iic-jku/SKY130_PLL1/buffer.JPG

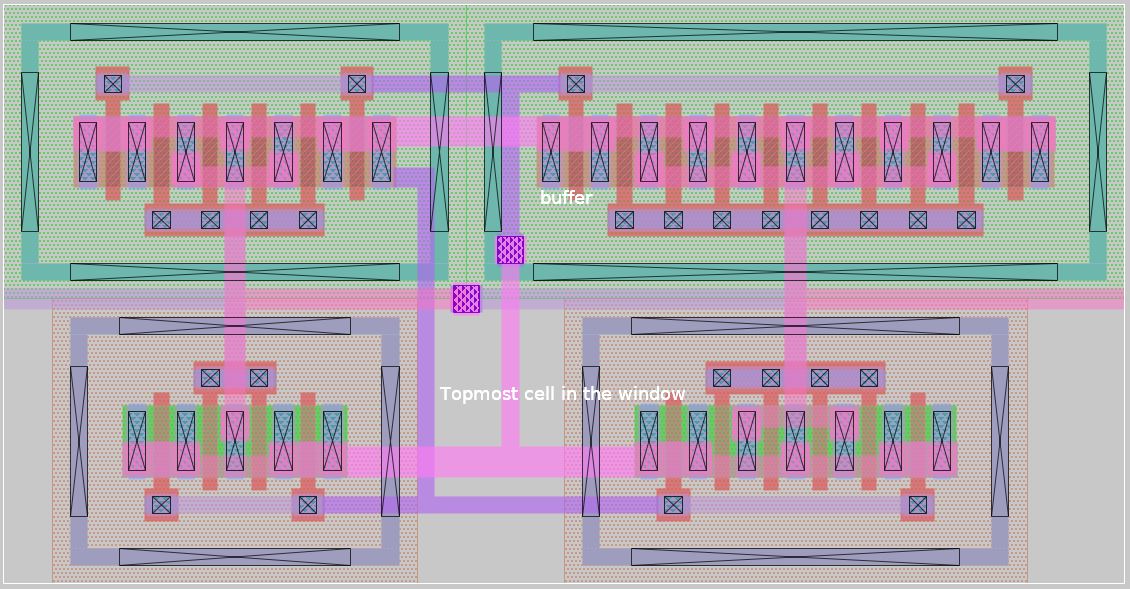
buffer.JPG
