iic-jku/SKY130_PLL1/core_final.JPG

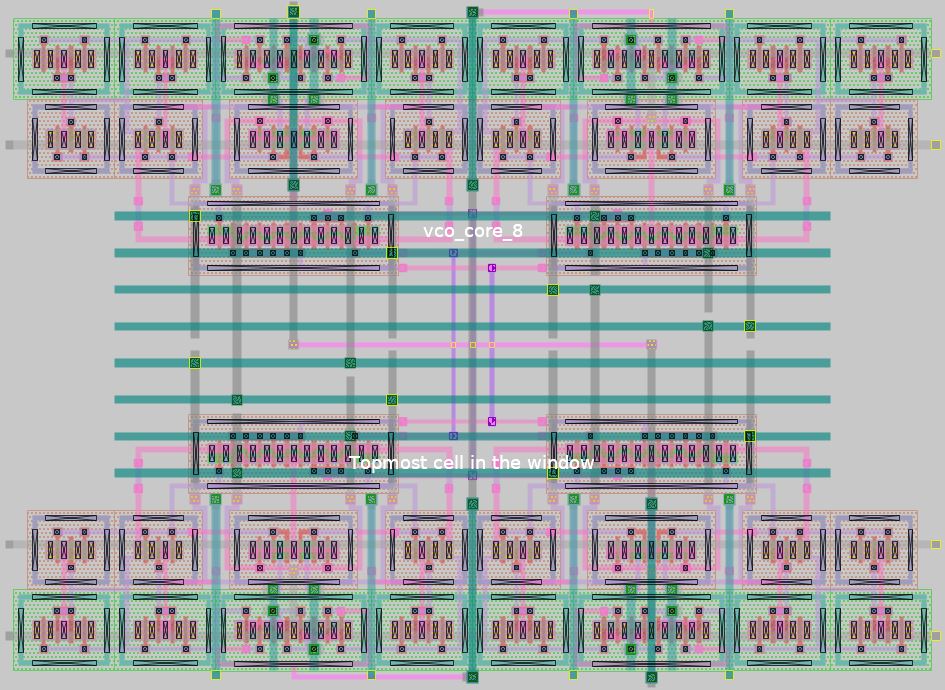
core_final.JPG
