iic-jku/SKY130_PLL1/README.md

# pll2022
Implementation of a Sub-Sampling PLL targeting SerDes Applications
__________________________________________________________________

Submission(s) for precheck - 31.08.2022:
> folder "PICO Contest"
> includes Pin List as well as "pin dummy"(dummy project but with all the correct pins)
