iic-jku/SKY130_PLL1/eval/digital_configuration/sky130_pll_controller/s1_SPI_Master.runs/impl_1/.init_design.begin.rst

<?xml version="1.0"?>
<ProcessHandle Version="1" Minor="0">
    <Process Command=".planAhead." Owner="fath_local" Host="PABLO" Pid="19500">
    </Process>
</ProcessHandle>
