iic-jku/SKY130_PLL1/eval/digital_configuration/sky130_pll_peripheral/sky130_pll_peripheral.runs/synth_1/.vivado.begin.rst

<?xml version="1.0"?>
<ProcessHandle Version="1" Minor="0">
    <Process Command="vivado.bat" Owner="fath_local" Host="PABLO" Pid="7096" HostCore="8" HostMemory="034122080256">
    </Process>
</ProcessHandle>
