iic-jku/SKY130_PLL1/PICO Contest/presentation.pptx

## Implementation of a Sub-Sampling PLL targeting SerDes Applications

Christof Gindu, BSc
Rohish Kumar Reddy Mitta, MSc
Univ.-Prof. Dr. Harald Pretl

## Team

- Christof Gindu, BSc Student
- Rohish Kumar Reddy Mitta, MSc PhD candidate, supervisor
- Univ.-Prof. Dr. Harald Pretl head of institute, supervisor

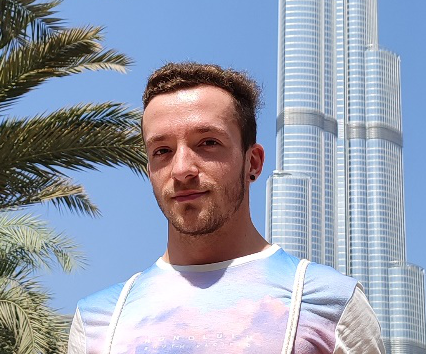
[picture p14: figure]
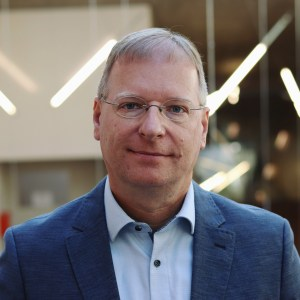
[picture p15: figure]

## Block schematic

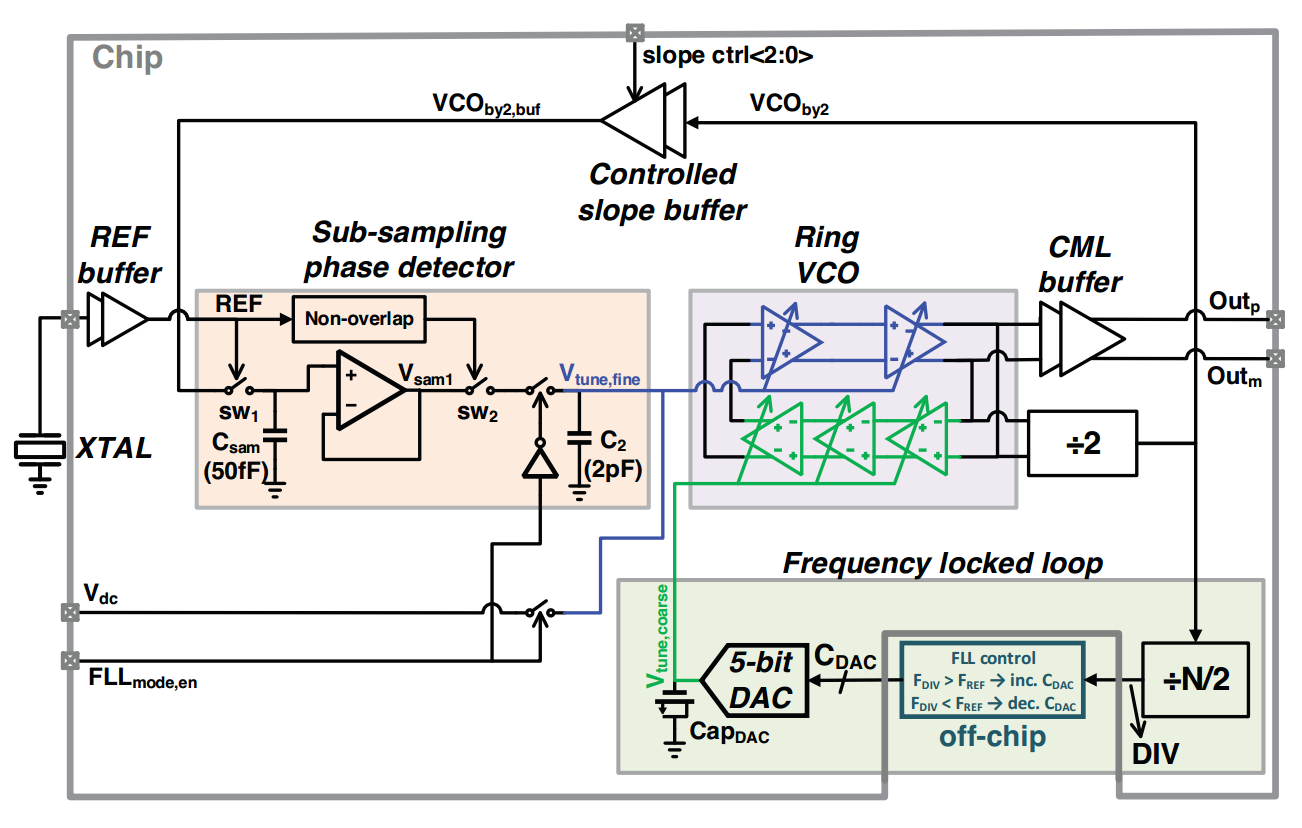
[picture p16: figure]

- S. S. Nagam and P. R. Kinget, "A 0.008mm2 2.4GHz type-I sub-sampling ring-oscillator-based phase-locked loop with a −239.7dB FoM and −64dBc reference spurs," 2018 IEEE Custom Integrated Circuits Conference (CICC), 2018, pp. 1-4, doi: 10.1109/CICC.2018.8357091.

## Proposed block schematic


## Specifications

- Center frequency = 1.25 GHz -> SerDes Applications
- Input frequency = 10-100 MHz (26 MHz) (mobile Applications)
- Power supply = 1.80V
- Power budget = 5 mW maximum
- Design focus on low power consumption (switching off circuit components)
- Design focus on PVT corners

## Ring VCO simulation

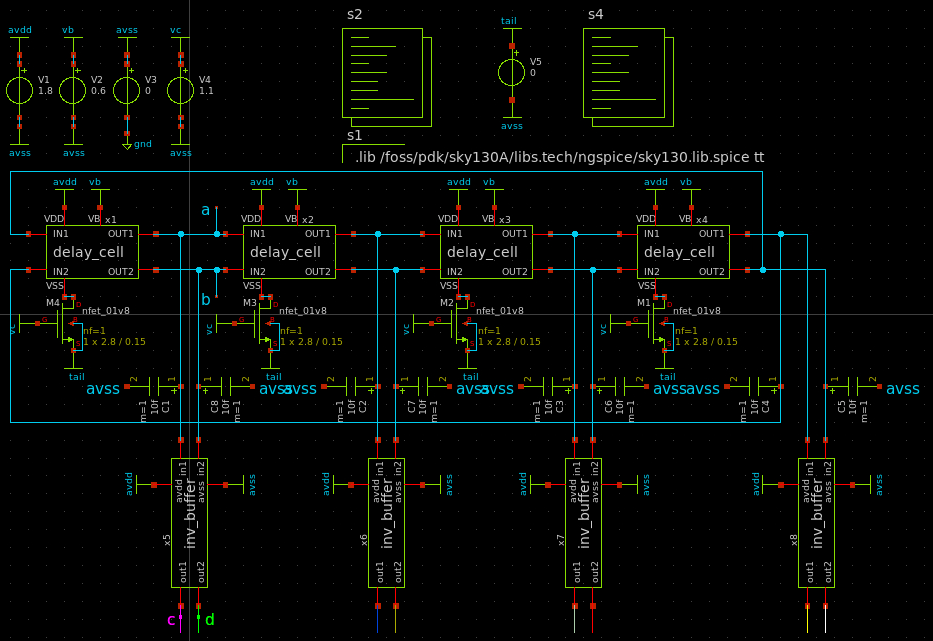
[picture p17: figure]

## Simulation results

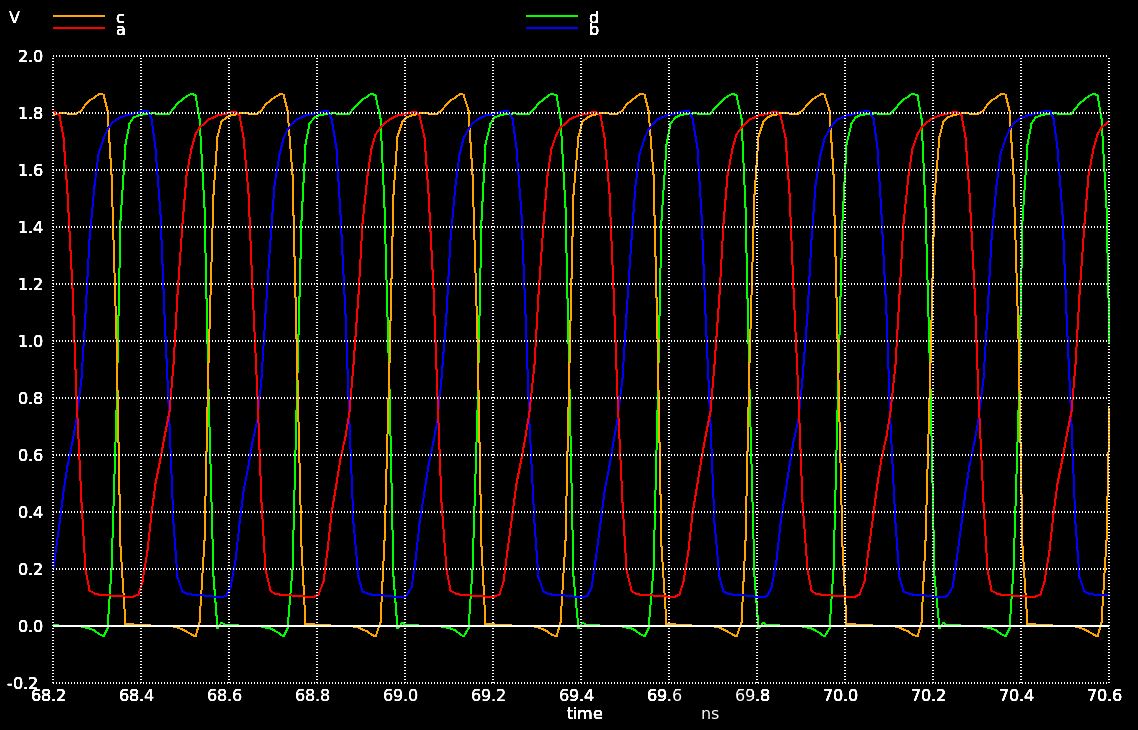
[picture p18: figure]

## Simulation results

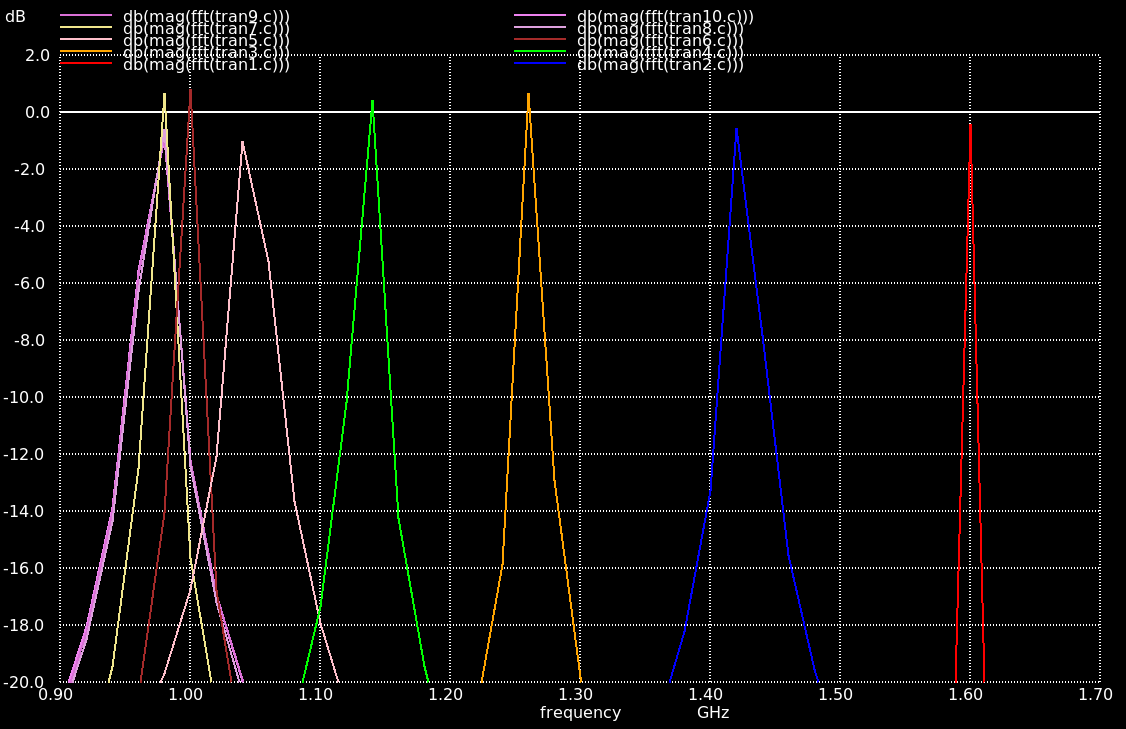
[picture p19: figure]

## VCO behavior

## Layout of the delay cell

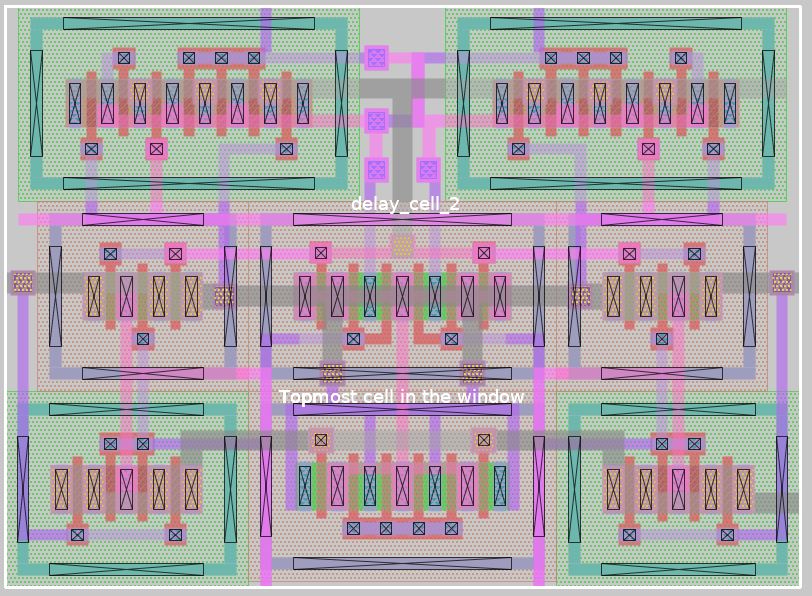
[picture p20: figure]

## Layout of the complete ring VCO

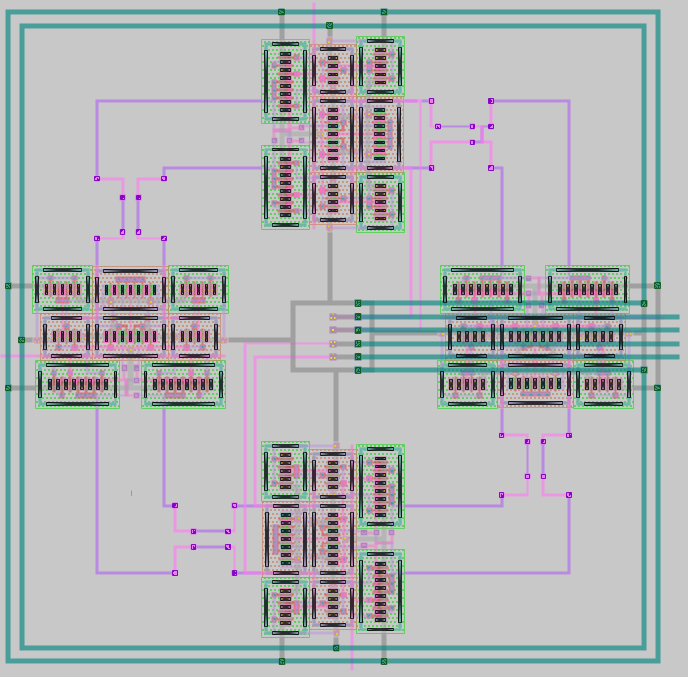
[picture p21: figure]

## Next steps

- Improve top speed of ring VCO
- Improve tuning range of ring VCO
- Start with extractions
- Continue with next circuit components

## Design challenges

- Extractions for LVS
- Parasitic extraction
- Incorporating all PVT corners

## Thank you!

Any questions / recommendations / feedback?
