iic-jku/SKY130_PLL1/PICO Contest/caravel_user_project_analog/README.md

# Caravel Analog User

  

---

| :exclamation: Important Note            |
|-----------------------------------------|

## Please fill in your project documentation in this README.md file
sub-sampling PLL targeting SerDes Applications
**********************************************
13 Pins in total
3x supply (vdd/vss)
1x REF in
1x s_in
1x read
1x load
1x clk
1x s_out
1x OUT

:warning: | Use this sample project for analog user projects. 
:---: | :---

---

Refer to [README](docs/source/index.rst) for this sample project documentation.
