iic-jku/SKY130_PLL1/Verilog/wrapper/runs/RUN_2023.03.12_07.43.52/reports/routing/18-wire_lengths.csv

net | length_um
clknet_0_clk_in | 398.89
_0478_ | 345.38
_0750_ | 331.885
_0757_ | 318.275
_0911_ | 293.235
net2 | 286.015
_0773_ | 186.75
_0771_ | 178.395
d5.fll_core.strobe | 175.14
clknet_4_2_0_clk_in | 174.155
_0923_ | 172.43
_0777_ | 169.995
_0769_ | 169.785
_0912_ | 162.215
_0508_ | 160.755
_0761_ | 159.125
_0979_ | 153.11
_0775_ | 147.905
_0776_ | 146.74
_0751_ | 144.09
_0758_ | 142.845
clknet_4_8_0_clk_in | 142.38
net28 | 141.975
_0756_ | 139.835
clknet_4_11_0_clk_in | 138.785
d2.t_load\[33\] | 138.62
net19 | 138.09
_0760_ | 136.29
clk_in | 134.655
_0574_ | 134.585
_0755_ | 134.015
_0968_ | 133.905
clknet_4_13_0_clk_in | 132.52
_0754_ | 132.03
clknet_4_10_0_clk_in | 131.93
net36 | 131.175
_0498_ | 130.285
clknet_1_0__leaf_ref_in | 130.03
_0542_ | 129.875
net27 | 129.23
_0770_ | 128.33
_0530_ | 127.66
_0772_ | 127.545
_0774_ | 126.88
clknet_4_5_0_clk_in | 126.35
d2.t_load\[59\] | 125.965
_0552_ | 123.975
d2.t_load\[58\] | 122.455
_0945_ | 120.85
d5.fll_core.tmp\[9\] | 120.61
net44 | 120.385
_0497_ | 119.95
_0934_ | 119.195
_0618_ | 118.48
clknet_4_14_0_clk_in | 117.87
_0520_ | 117.85
_0640_ | 116.67
net43 | 115.195
_0596_ | 114.685
_0630_ | 114.61
clknet_4_4_0_clk_in | 112.61
d2.t_load\[60\] | 111.995
d5.fll_core.tmp\[7\] | 111.77
net20 | 111.315
clknet_1_1__leaf_ref_in | 110.855
d5.fll_core.tmp\[2\] | 110.415
net18 | 110.17
net42 | 109.94
d5.fll_core.tmp\[8\] | 109.905
_0954_ | 109.73
clknet_4_0_0_clk_in | 109.615
d2.t_load\[31\] | 108.895
d2.t_load\[65\] | 108.82
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
_0527_ | 1.695
_0604_ | 1.695
_0027_ | 1.575
_0049_ | 1.575
_0057_ | 1.575
_0060_ | 1.575
_0071_ | 1.575
_0079_ | 1.575
_0107_ | 1.575
_0110_ | 1.575
_0121_ | 1.575
_0127_ | 1.575
_0177_ | 1.575
_0198_ | 1.575
_0205_ | 1.575
_0241_ | 1.575
_0407_ | 1.545
_0628_ | 1.45
_0706_ | 1.45
