iic-jku/SKY130_PLL1/Verilog/wrapper/runs/RUN_2022.11.11_11.09.27/reports/routing/18-wire_lengths.csv

net | length_um
clknet_0_clk_in | 392.18
_0802_ | 345.365
_0772_ | 327.065
net2 | 316.435
_0780_ | 305.995
_0892_ | 265.6
_0784_ | 221.5
_0795_ | 219.115
_0530_ | 197.77
_0783_ | 189.93
_0574_ | 184.62
_0794_ | 181.915
_0814_ | 172.805
_0790_ | 166.215
d5.fll_core.strobe | 165.015
clknet_4_10_0_clk_in | 159.14
_0791_ | 158.77
net27 | 157.075
_0542_ | 151.49
_0792_ | 150.205
clknet_4_15_0_clk_in | 149.045
_0608_ | 148.92
net18 | 143.77
_0618_ | 143.61
_0836_ | 142.74
_0789_ | 141.975
_0788_ | 141.625
_0848_ | 141.55
_0803_ | 141.115
_0870_ | 140.865
net17 | 140.72
clknet_4_5_0_clk_in | 140.565
_0793_ | 140.09
_0777_ | 138.36
_0859_ | 138.18
clknet_4_3_0_clk_in | 135.29
_0652_ | 134.57
_0847_ | 131.315
d2.t_load\[44\] | 131.215
d5.fll_core.tmp\[0\] | 130.6
_0519_ | 128.265
d5.fll_core.tmp\[2\] | 128.09
_0520_ | 127.9
_0785_ | 127.655
_0781_ | 126.915
net26 | 126.63
_0778_ | 126.065
clk_in | 124.995
clknet_4_13_0_clk_in | 123.29
clknet_4_8_0_clk_in | 122.3
_0596_ | 121.83
d2.t_load\[58\] | 121.295
clknet_1_1__leaf_ref_in | 120.695
_0773_ | 120.595
_0564_ | 120.385
_0779_ | 120.305
net19 | 120.225
d2.t_load\[33\] | 119.895
net43 | 119.86
clknet_4_9_0_clk_in | 116.865
_0825_ | 115.94
clknet_1_0__leaf_ref_in | 115.52
_0491_ | 115.35
_0776_ | 115.09
net35 | 114.605
clknet_4_11_0_clk_in | 114.455
d2.t_load\[56\] | 113.65
d2.t_load\[57\] | 113.625
_0782_ | 112.88
d5.fll_core.tmp\[9\] | 112.34
d2.t_load\[62\] | 112.255
clknet_4_2_0_clk_in | 111.71
clknet_4_14_0_clk_in | 110.415
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
_0307_ | 1.79
_0309_ | 1.79
_0328_ | 1.79
_0341_ | 1.79
_0422_ | 1.79
_0334_ | 1.76
_0507_ | 1.695
_0675_ | 1.695
_0027_ | 1.575
_0029_ | 1.575
_0055_ | 1.575
_0067_ | 1.575
_0099_ | 1.575
_0126_ | 1.575
_0157_ | 1.575
_0199_ | 1.575
_0232_ | 1.575
_0251_ | 1.575
_0517_ | 1.45
_0613_ | 1.45
