iic-jku/SKY130_PLL1/delay_cell.JPG

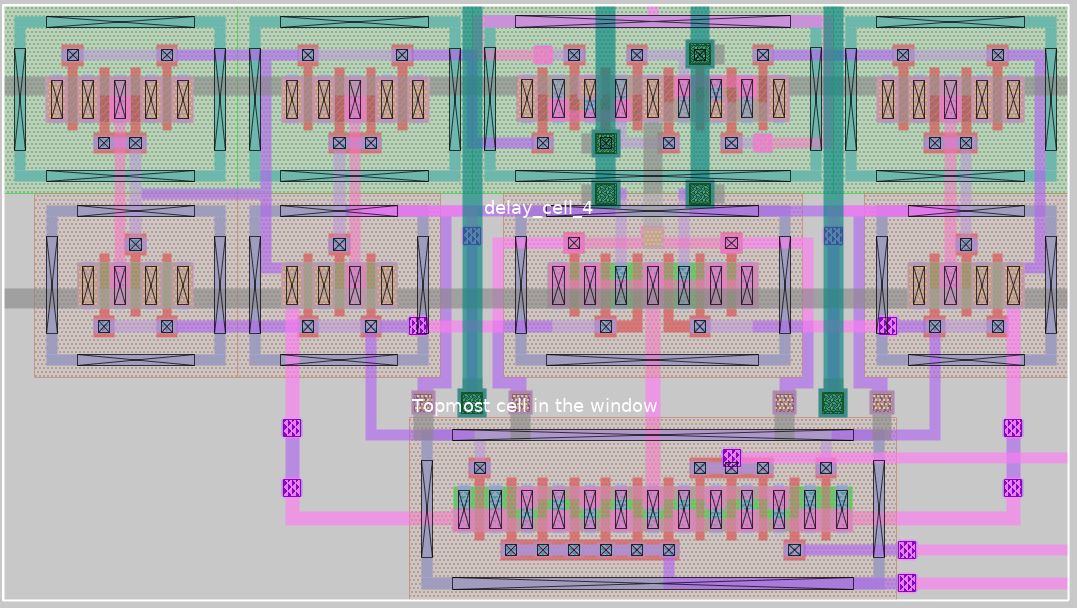
delay_cell.JPG
