iic-jku/SKY130_PLL1/eval/caravan_pad.png

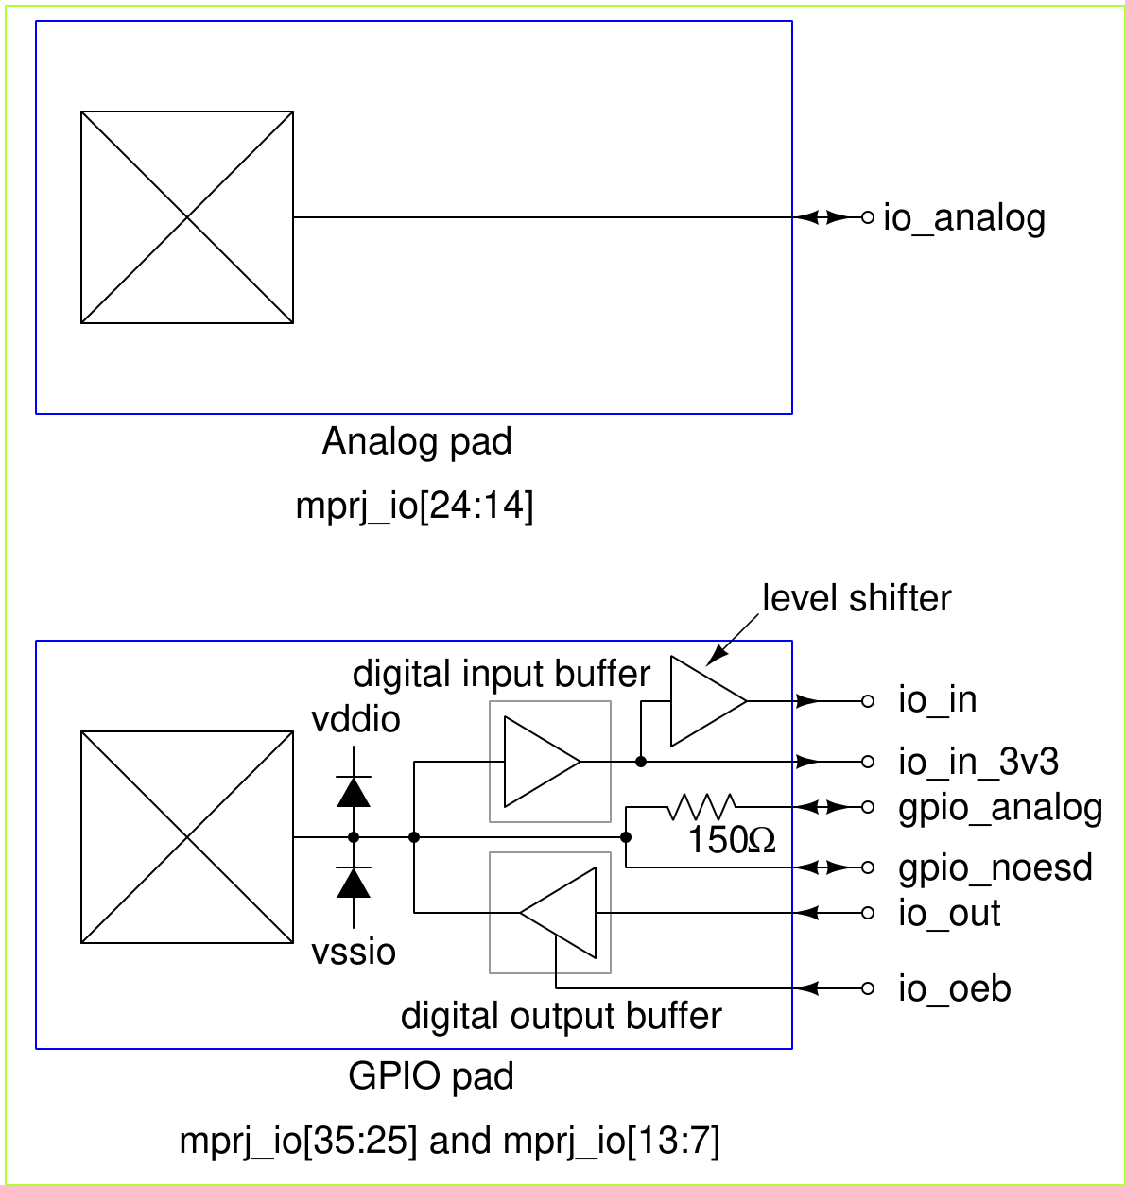
eval/caravan_pad.png
