iic-jku/SKY130_PLL1/eval/SKY130_PLL_eval_PCB/aisler_pcb_stackup.jpeg

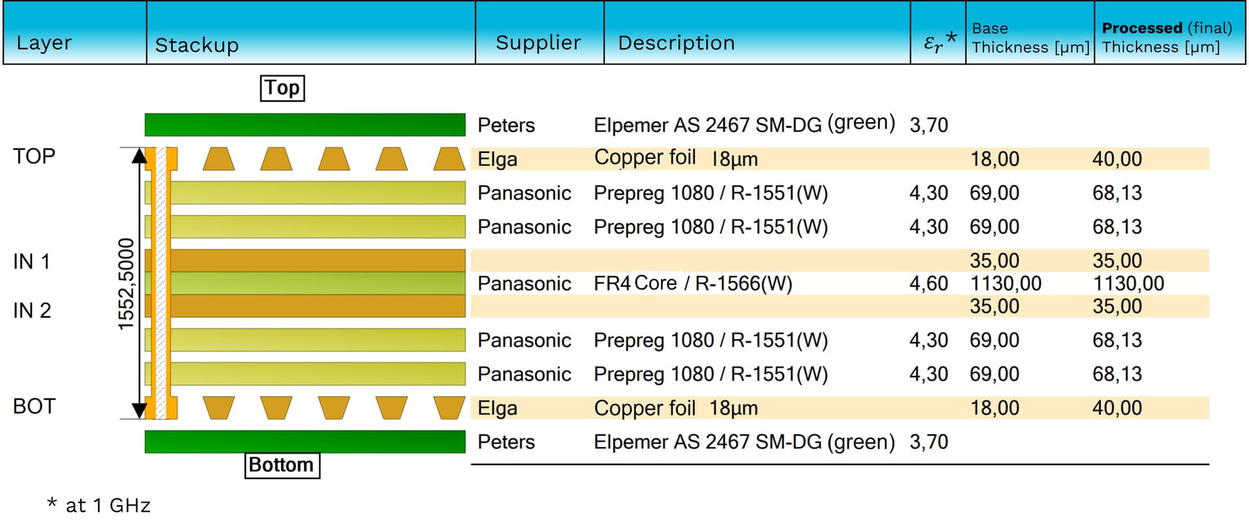
eval/SKY130_PLL_eval_PCB/aisler_pcb_stackup.jpeg
