iic-jku/SKY130_PLL1/eval/SKY130_PLL_eval_PCB/Orderlist.txt

2x ADM7154ARDZ-1.8-R7 7€ https://www.digikey.at/en/products/detail/analog-devices-inc/ADM7154ARDZ-1-8-R7/5055886
