iic-jku/SKY130_PLL1/Verilog/fll_2/runs/RUN_2022.10.07_08.59.13/reports/final_summary_report.csv

 | design | design_name | config | flow_status | total_runtime | routed_runtime | (Cell/mm^2)/Core_Util | DIEAREA_mm^2 | CellPer_mm^2 | OpenDP_Util | Peak_Memory_Usage_MB | cell_count | tritonRoute_violations | Short_violations | MetSpc_violations | OffGrid_violations | MinHole_violations | Other_violations | Magic_violations | antenna_violations | lvs_total_errors | cvc_total_errors | klayout_violations | wire_length | vias | wns | pl_wns | optimized_wns | fastroute_wns | spef_wns | tns | pl_tns | optimized_tns | fastroute_tns | spef_tns | HPWL | routing_layer1_pct | routing_layer2_pct | routing_layer3_pct | routing_layer4_pct | routing_layer5_pct | routing_layer6_pct | wires_count | wire_bits | public_wires_count | public_wire_bits | memories_count | memory_bits | processes_count | cells_pre_abc | AND | DFF | NAND | NOR | OR | XOR | XNOR | MUX | inputs
0 | /foss/designs/ma2022/fll_2 | fll_wrapper_2 | RUN_2022.10.07_08.59.13 | flow completed | 0h3m17s0ms | 0h2m43s0ms | -2.0 | 0.010372210625 | -1 | 53.4 | 475.58 | -1 | 0 | 0 | 0 | 0 | 0 | 0 | 0 | 0 | 0 | 0 | -1 | 9878 | 2527 | 0.0 | 0.0 | -1 | 0.0 | 0.0 | 0.0 | 0.0 | -1 | 0.0 | 0.0 | 5502447.0 | 0.0 | 31.5 | 30.67 | 3.16 | 1.16 | 0.0 | 384 | 691 | 45 | 240 | 0 | 0 | 0 | 428 | 20 | 41 | 22 | 17 | 40 | 81 | 19 | 1 | 86
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
