iic-jku/SKY130_PLL1/Verilog/fll_2/runs/RUN_2022.11.02_10.21.17/reports/final_summary_report.csv

 | design | design_name | config | flow_status | total_runtime | routed_runtime | (Cell/mm^2)/Core_Util | DIEAREA_mm^2 | CellPer_mm^2 | OpenDP_Util | Peak_Memory_Usage_MB | cell_count | tritonRoute_violations | Short_violations | MetSpc_violations | OffGrid_violations | MinHole_violations | Other_violations | Magic_violations | antenna_violations | lvs_total_errors | cvc_total_errors | klayout_violations | wire_length | vias | wns | pl_wns | optimized_wns | fastroute_wns | spef_wns | tns | pl_tns | optimized_tns | fastroute_tns | spef_tns | HPWL | routing_layer1_pct | routing_layer2_pct | routing_layer3_pct | routing_layer4_pct | routing_layer5_pct | routing_layer6_pct | wires_count | wire_bits | public_wires_count | public_wire_bits | memories_count | memory_bits | processes_count | cells_pre_abc | AND | DFF | NAND | NOR | OR | XOR | XNOR | MUX | inputs
0 | /foss/designs/ma2022/fll_2 | fll_wrapper_2 | RUN_2022.11.02_10.21.17 | flow failed | 0h0m26s0ms | -1 | -2.0 | 0.0095067929 | -1 | 54.54 | -1 | -1 | -1 | -1 | -1 | -1 | -1 | -1 | -1 | -1 | -1 | -1 | -1 | -1 | -1 | 0.0 | 0.0 | -1 | -1 | -1 | 0.0 | 0.0 | -1 | -1 | -1 | 6793029.0 | -1 | -1 | -1 | -1 | -1 | -1 | 334 | 668 | 48 | 288 | 0 | 0 | 0 | 366 | 14 | 31 | 15 | 17 | 46 | 70 | 12 | 11 | 77
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
