iic-jku/SKY130_PLL1/Verilog/freqdiv/runs/RUN_2022.10.19_14.29.10/reports/final_summary_report.csv

 | design | design_name | config | flow_status | total_runtime | routed_runtime | (Cell/mm^2)/Core_Util | DIEAREA_mm^2 | CellPer_mm^2 | OpenDP_Util | Peak_Memory_Usage_MB | cell_count | tritonRoute_violations | Short_violations | MetSpc_violations | OffGrid_violations | MinHole_violations | Other_violations | Magic_violations | antenna_violations | lvs_total_errors | cvc_total_errors | klayout_violations | wire_length | vias | wns | pl_wns | optimized_wns | fastroute_wns | spef_wns | tns | pl_tns | optimized_tns | fastroute_tns | spef_tns | HPWL | routing_layer1_pct | routing_layer2_pct | routing_layer3_pct | routing_layer4_pct | routing_layer5_pct | routing_layer6_pct | wires_count | wire_bits | public_wires_count | public_wire_bits | memories_count | memory_bits | processes_count | cells_pre_abc | AND | DFF | NAND | NOR | OR | XOR | XNOR | MUX | inputs
0 | /foss/designs/ma2022/freqdiv | clock_divider | RUN_2022.10.19_14.29.10 | flow failed | 0h7m40s0ms | 0h6m59s0ms | -2.0 | 0.0034723593 | -1 | 57.79 | 468.0 | -1 | 0 | 0 | 0 | 0 | 0 | 0 | 0 | 0 | 0 | 0 | -1 | 2121 | 421 | -0.35 | -0.4 | -1 | -0.41 | -0.4 | -0.35 | -0.4 | -1 | -0.41 | -0.4 | 174134.0 | 0.0 | 20.18 | 23.09 | 0.49 | 1.5 | 0.0 | 115 | 196 | 3 | 30 | 0 | 0 | 0 | 167 | 2 | 1 | 13 | 2 | 72 | 14 | 13 | 28 | 28
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
