iic-jku/SKY130_PLL1/Verilog/shiftregister/runs/RUN_2022.10.07_16.07.28/reports/final_summary_report.csv

 | design | design_name | config | flow_status | total_runtime | routed_runtime | (Cell/mm^2)/Core_Util | DIEAREA_mm^2 | CellPer_mm^2 | OpenDP_Util | Peak_Memory_Usage_MB | cell_count | tritonRoute_violations | Short_violations | MetSpc_violations | OffGrid_violations | MinHole_violations | Other_violations | Magic_violations | antenna_violations | lvs_total_errors | cvc_total_errors | klayout_violations | wire_length | vias | wns | pl_wns | optimized_wns | fastroute_wns | spef_wns | tns | pl_tns | optimized_tns | fastroute_tns | spef_tns | HPWL | routing_layer1_pct | routing_layer2_pct | routing_layer3_pct | routing_layer4_pct | routing_layer5_pct | routing_layer6_pct | wires_count | wire_bits | public_wires_count | public_wire_bits | memories_count | memory_bits | processes_count | cells_pre_abc | AND | DFF | NAND | NOR | OR | XOR | XNOR | MUX | inputs
0 | /foss/designs/ma2022/shiftregister | shiftregister | RUN_2022.10.07_16.07.28 | flow completed | 0h3m3s0ms | 0h2m30s0ms | -2.5 | 0.010809121425000002 | -1 | 42.5 | 474.66 | -1 | 0 | 0 | 0 | 0 | 0 | 0 | 0 | 0 | 0 | 0 | -1 | 9796 | 2104 | 0.0 | 0.0 | -1 | 0.0 | 0.0 | 0.0 | 0.0 | -1 | 0.0 | 0.0 | 6604830.0 | 0.0 | 25.4 | 33.2 | 1.47 | 2.28 | 0.0 | 43 | 167 | 10 | 134 | 0 | 0 | 0 | 97 | 0 | 0 | 0 | 0 | 0 | 0 | 0 | 32 | 100
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
