iic-jku/SKY130_PLL1/Verilog/shiftregister/runs/RUN_2022.11.02_10.28.11/reports/final_summary_report.csv

 | design | design_name | config | flow_status | total_runtime | routed_runtime | (Cell/mm^2)/Core_Util | DIEAREA_mm^2 | CellPer_mm^2 | OpenDP_Util | Peak_Memory_Usage_MB | cell_count | tritonRoute_violations | Short_violations | MetSpc_violations | OffGrid_violations | MinHole_violations | Other_violations | Magic_violations | antenna_violations | lvs_total_errors | cvc_total_errors | klayout_violations | wire_length | vias | wns | pl_wns | optimized_wns | fastroute_wns | spef_wns | tns | pl_tns | optimized_tns | fastroute_tns | spef_tns | HPWL | routing_layer1_pct | routing_layer2_pct | routing_layer3_pct | routing_layer4_pct | routing_layer5_pct | routing_layer6_pct | wires_count | wire_bits | public_wires_count | public_wire_bits | memories_count | memory_bits | processes_count | cells_pre_abc | AND | DFF | NAND | NOR | OR | XOR | XNOR | MUX | inputs
0 | /foss/designs/ma2022/shiftregister | shiftregister | RUN_2022.11.02_10.28.11 | flow completed | 0h4m27s0ms | 0h3m41s0ms | -2.5 | 0.0320588273 | -1 | 42.1 | 494.32 | -1 | 0 | 0 | 0 | 0 | 0 | 0 | 0 | 6 | 0 | 0 | -1 | 43592 | 7562 | 0.0 | 0.0 | -1 | 0.0 | 0.0 | 0.0 | 0.0 | -1 | 0.0 | 0.0 | 32690613.0 | 0.0 | 40.5 | 43.52 | 4.52 | 6.72 | 0.0 | 110 | 506 | 10 | 406 | 0 | 0 | 0 | 300 | 0 | 0 | 0 | 0 | 0 | 0 | 0 | 100 | 304
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
