iic-jku/SKY130_PLL1/Verilog/shiftregister/runs/RUN_2022.11.02_11.37.08/reports/final_summary_report.csv

 | design | design_name | config | flow_status | total_runtime | routed_runtime | (Cell/mm^2)/Core_Util | DIEAREA_mm^2 | CellPer_mm^2 | OpenDP_Util | Peak_Memory_Usage_MB | cell_count | tritonRoute_violations | Short_violations | MetSpc_violations | OffGrid_violations | MinHole_violations | Other_violations | Magic_violations | antenna_violations | lvs_total_errors | cvc_total_errors | klayout_violations | wire_length | vias | wns | pl_wns | optimized_wns | fastroute_wns | spef_wns | tns | pl_tns | optimized_tns | fastroute_tns | spef_tns | HPWL | routing_layer1_pct | routing_layer2_pct | routing_layer3_pct | routing_layer4_pct | routing_layer5_pct | routing_layer6_pct | wires_count | wire_bits | public_wires_count | public_wire_bits | memories_count | memory_bits | processes_count | cells_pre_abc | AND | DFF | NAND | NOR | OR | XOR | XNOR | MUX | inputs
0 | /foss/designs/ma2022/shiftregister | shiftregister | RUN_2022.11.02_11.37.08 | flow completed | 0h16m6s0ms | 0h15m18s0ms | -2.2222222222222223 | 0.028811801025 | -1 | 47.05 | 500.13 | -1 | 0 | 0 | 0 | 0 | 0 | 0 | 0 | 5 | 0 | 0 | -1 | 64367 | 9513 | 0.0 | 0.0 | -1 | 0.0 | 0.0 | 0.0 | 0.0 | -1 | 0.0 | 0.0 | 30224199.0 | 0.0 | 60.17 | 68.31 | 46.84 | -1 | 59.87 | 110 | 506 | 10 | 406 | 0 | 0 | 0 | 300 | 0 | 0 | 0 | 0 | 0 | 0 | 0 | 100 | 304
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
