iic-jku/SKY130_PLL1/Verilog/wrapper/runs/RUN_2023.03.12_07.43.52/reports/metrics.csv

design | design_name | config | flow_status | total_runtime | routed_runtime | (Cell/mm^2)/Core_Util | DIEAREA_mm^2 | CellPer_mm^2 | OpenDP_Util | Peak_Memory_Usage_MB | cell_count | tritonRoute_violations | Short_violations | MetSpc_violations | OffGrid_violations | MinHole_violations | Other_violations | Magic_violations | antenna_violations | lvs_total_errors | cvc_total_errors | klayout_violations | wire_length | vias | wns | pl_wns | optimized_wns | fastroute_wns | spef_wns | tns | pl_tns | optimized_tns | fastroute_tns | spef_tns | HPWL | routing_layer1_pct | routing_layer2_pct | routing_layer3_pct | routing_layer4_pct | routing_layer5_pct | routing_layer6_pct | wires_count | wire_bits | public_wires_count | public_wire_bits | memories_count | memory_bits | processes_count | cells_pre_abc | AND | DFF | NAND | NOR | OR | XOR | XNOR | MUX | inputs | outputs
/foss/designs/ma2022/wrapper | wrapper | RUN_2023.03.12_07.43.52 | flow completed | 0h2m39s0ms | 0h1m42s0ms | -2.5 | 0.039566300624999995 | -1 | 41.56 | 608.09 | -1 | 0 | 0 | 0 | 0 | 0 | 0 | 0 | -1 | 0 | -1 | -1 | 30148 | 7929 | 0.0 | 0.0 | 0.0 | 0.0 | 0.0 | 0.0 | 0.0 | 0.0 | 0.0 | 0.0 | 18013773.0 | 0.0 | 23.26 | 25.14 | 0.0 | -1 | 18.23 | 463 | 1344 | 89 | 876 | 0 | 0 | 0 | 658 | 15 | 31 | 11 | 16 | 43 | 71 | 10 | 118 | 231 | 484
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
