iic-jku/SKY130_PLL1/Verilog/wrapper/runs/RUN_2022.11.11_11.09.27/reports/metrics.csv

design | design_name | config | flow_status | total_runtime | routed_runtime | (Cell/mm^2)/Core_Util | DIEAREA_mm^2 | CellPer_mm^2 | OpenDP_Util | Peak_Memory_Usage_MB | cell_count | tritonRoute_violations | Short_violations | MetSpc_violations | OffGrid_violations | MinHole_violations | Other_violations | Magic_violations | antenna_violations | lvs_total_errors | cvc_total_errors | klayout_violations | wire_length | vias | wns | pl_wns | optimized_wns | fastroute_wns | spef_wns | tns | pl_tns | optimized_tns | fastroute_tns | spef_tns | HPWL | routing_layer1_pct | routing_layer2_pct | routing_layer3_pct | routing_layer4_pct | routing_layer5_pct | routing_layer6_pct | wires_count | wire_bits | public_wires_count | public_wire_bits | memories_count | memory_bits | processes_count | cells_pre_abc | AND | DFF | NAND | NOR | OR | XOR | XNOR | MUX | inputs | outputs
/foss/designs/ma2022/wrapper | wrapper | RUN_2022.11.11_11.09.27 | flow completed | 0h5m46s0ms | 0h3m43s0ms | -2.5 | 0.039614071425 | -1 | 41.5 | 604.66 | -1 | 0 | 0 | 0 | 0 | 0 | 0 | 0 | -1 | 0 | -1 | -1 | 29139 | 7870 | 0.0 | 0.0 | 0.0 | 0.0 | 0.0 | 0.0 | 0.0 | 0.0 | 0.0 | 0.0 | 17743006.0 | 0.0 | 23.22 | 25.43 | 0.0 | -1 | 18.31 | 454 | 1335 | 82 | 869 | 0 | 0 | 0 | 654 | 15 | 31 | 11 | 18 | 42 | 72 | 9 | 117 | 230 | 481
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
