iic-jku/SKY130_PLL1/eval/digital_configuration/sky130_pll_controller/s1_SPI_Master.runs/impl_1/usage_statistics_webtalk.html

### Device Usage Page (usage_statistics_webtalk.html)

This HTML page displays the device usage statistics that will be sent to Xilinx.
To see the actual file transmitted to Xilinx, please click here.

software_version_and_target_device
beta | FALSE | build_version | 3064766
date_generated | Mon Apr 22 14:48:11 2024 | os_platform | WIN64
product_version | Vivado v2020.2 (64-bit) | project_id | 4e50925d56e44157b7875b5a26638259
project_iteration | 253 | random_id | 709c6eeba3965181aa36ec5cebbeb72b
registration_id | 212039415_0_0_326 | route_design | TRUE
target_device | xc7a35ti | target_family | artix7
target_package | csg324 | target_speed | -1L
tool_flow | Vivado

user_environment
cpu_name | Intel(R) Core(TM) i5-10210U CPU @ 1.60GHz | cpu_speed | 2112 MHz
os_name | Windows Server 2016 or Windows 10 | os_release | major release (build 9200)
system_ram | 34.000 GB | total_processors | 1

vivado_usage

gui_handlers
abstractfileview_reload=1 | addsrcwizard_specify_hdl_netlist_block_design=1 | addsrcwizard_specify_or_create_constraint_files=1 | basedialog_apply=1
basedialog_cancel=41 | basedialog_ok=271 | basedialog_yes=4 | cfgmempartchooser_table=5
cmdmsgdialog_ok=37 | confirmsavetexteditsdialog_no=1 | confirmsavetexteditsdialog_yes=4 | coretreetablepanel_core_tree_table=34
createsrcfiledialog_file_name=1 | customizecoredialog_documentation=1 | customizecoredialog_ip_location=1 | customizecoredialog_switch_to_defaults=1
filesetpanel_file_set_panel_tree=673 | findandreplacealldialog_find=3 | findinfilesview_replace_all_occurrences_in_all_files=3 | findinfilesview_root=11
floatingtopdialog_ignore_and_continue_with_invalid_top=1 | floatingtopdialog_select_top_module_of_your_design=1 | floatingtopdialog_specify_new_top_module=1 | flownavigatortreepanel_flow_navigator_tree=483
graphicalview_zoom_fit=9 | graphicalview_zoom_in=6 | graphicalview_zoom_out=21 | hardwaretreepanel_hardware_tree_table=306
hcodeeditor_close=57 | hcodeeditor_search_text_combo_box=125 | hinputhandler_toggle_block_comments=1 | hinputhandler_toggle_line_comments=8
hpopuptitle_close=2 | ipproppanel_upgrade_version=2 | labtoolsmenu_jtag_scan_rate=1 | mainmenumgr_checkpoint=7
mainmenumgr_edit=24 | mainmenumgr_file=34 | mainmenumgr_flow=10 | mainmenumgr_ip=3
mainmenumgr_open_recent_project=4 | mainmenumgr_project=17 | mainmenumgr_reports=8 | mainmenumgr_text_editor=1
mainmenumgr_tools=13 | mainmenumgr_window=6 | maintoolbarmgr_run=2 | mainwinmenumgr_layout=2
messagewithoptiondialog_dont_show_this_dialog_again=1 | msgtreepanel_discard_user_created_messages=14 | msgtreepanel_message_severity=20 | msgtreepanel_message_view_tree=89
msgview_critical_warnings=1 | msgview_error_messages=7 | msgview_information_messages=6 | msgview_warning_messages=16
navigabletimingreporttab_timing_report_navigation_tree=1 | netlisttreeview_netlist_tree=2 | numjobschooser_number_of_jobs=1 | openfileaction_ok=1
openipexampledesign_example_project_directory=1 | pacodeeditor_find_usages=7 | pacodeeditor_goto_definition=30 | pacommandnames_add_config_memory=3
pacommandnames_add_sources=3 | pacommandnames_auto_connect_target=74 | pacommandnames_auto_update_hier=23 | pacommandnames_close_design=2
pacommandnames_close_project=4 | pacommandnames_generate_composite_file=1 | pacommandnames_open_hardware_manager=1 | pacommandnames_open_ip_example_design=1
pacommandnames_open_project=2 | pacommandnames_open_target=2 | pacommandnames_program_config_memory=204 | pacommandnames_program_fpga=3
pacommandnames_recustomize_core=25 | pacommandnames_replace_in_files=5 | pacommandnames_report_ip_status=1 | pacommandnames_reset_composite_file=2
pacommandnames_save_project_as=1 | pacommandnames_simulation_live_break=4 | pacommandnames_simulation_live_run=6 | pacommandnames_simulation_live_run_all=4
pacommandnames_simulation_reset_behavioral=2 | pacommandnames_simulation_reset_post_implementation_timing=1 | pacommandnames_simulation_reset_post_synthesis_functional=1 | pacommandnames_simulation_run_behavioral=1
pacommandnames_simulation_run_post_implementation_timing=1 | pacommandnames_simulation_settings=1 | pacommandnames_write_config_memory_file=1 | paviews_code=51
paviews_device=3 | paviews_ip_catalog=1 | paviews_project_summary=66 | paviews_schematic=1
paviews_tcl_object_view=2 | programcfgmemdialog_contents_of_configuration_file=7 | programdebugtab_open_recently_opened_target=3 | programdebugtab_open_target=41
programdebugtab_program_device=2 | programdebugtab_refresh_device=2 | programfpgadialog_program=1 | programfpgadialog_specify_bitstream_file=2
progressdialog_background=24 | progressdialog_cancel=3 | projectnamechooser_choose_project_location=1 | projectnamechooser_project_name=2
projecttab_close_design=1 | projecttab_reload=5 | quickhelp_help=1 | rdicommands_delete=14
rdicommands_properties=6 | rdiviews_waveform_viewer=6 | removesourcesdialog_also_delete=3 | rungadget_show_warning_and_error_messages_in_messages=1
saveprojectasdialog_include_run_results=1 | saveprojectutils_cancel=2 | saveprojectutils_save=37 | selecttopmoduledialog_select_top_module=1
settingsdialog_options_tree=1 | settingsdialog_project_tree=20 | simpleoutputproductdialog_apply_options_and_dismiss_dialog_without=3 | simpleoutputproductdialog_close_dialog_unsaved_changes_will=1
simpleoutputproductdialog_generate_output_products_immediately=14 | simpleoutputproductdialog_output_product_tree=3 | simpleoutputproductdialog_reset_output_products=2 | simpleoutputproductdialog_synthesize_all_ip_including_ip_contained=1
simpleoutputproductdialog_synthesize_design_globally=1 | simulationliverunforcomp_specify_time_and_units=1 | simulationscopespanel_simulate_scope_table=1 | srcchooserpanel_add_hdl_and_netlist_files_to_your_project=3
srcchooserpanel_create_file=1 | srcchooserpanel_make_local_copy_of_these_files_into=1 | srcfileproppanels_more_info=1 | srcmenu_ip_documentation=18
srcmenu_ip_hierarchy=18 | statemonitor_reset_run=5 | statemonitor_reset_step=1 | syntheticagettingstartedview_recent_projects=37
syntheticastatemonitor_cancel=36 | taskbanner_close=44 | tclconsoleview_tcl_console_code_editor=9 | tclobjecttreetable_treetable=17
upgradeip_convert_ip_to_core_container_and_set=2 | upgradeip_ok=1 | waveformview_add_marker=1 | waveformview_next_transition=1
xpg_ipsymbol_show_disabled_ports=2 | xpg_tabbedpane_tabbed_pane=3 | xpowersettingsdialog_save_these_settings_and_run=1

java_command_handlers
addcfgmem=5 | addsources=4 | autoconnecttarget=73 | closedesign=2
closeproject=6 | coreview=4 | createblockdesign=1 | customizecore=3
editdelete=16 | editpaste=8 | editproperties=6 | editundo=20
exitapp=40 | launchprogramfpga=5 | managecompositetargets=3 | openhardwaremanager=71
openipexampledesign=1 | openproject=2 | openrecenttarget=42 | opentarget=2
programcfgmem=212 | programdevice=11 | recustomizecore=29 | refreshdevice=2
reportipstatus=1 | reporttimingsummary=2 | resetlayout=1 | runbitgen=287
runimplementation=6 | runpowerestimation=1 | runschematic=3 | runsynthesis=15
savefileproxyhandler=17 | saveprojectas=2 | showpowerestimation=1 | showview=9
simulationbreak=4 | simulationclose=1 | simulationrun=5 | simulationrunall=4
simulationrunfortime=5 | toolssettings=8 | ui.views.c.h.e=5 | upgradeip=2
viewtaskimplementation=1 | viewtaskprogramanddebug=1 | viewtaskprojectmanager=2 | viewtaskrtlanalysis=2
viewtasksynthesis=3 | writecfgmemfile=1

other_data

guimode=84

project_data
constraintsetcount=1 | core_container=true | currentimplrun=impl_1 | currentsynthesisrun=synth_1
default_library=xil_defaultlib | designmode=RTL | export_simulation_activehdl=13 | export_simulation_ies=13
export_simulation_modelsim=13 | export_simulation_questa=13 | export_simulation_riviera=13 | export_simulation_vcs=13
export_simulation_xsim=13 | implstrategy=Vivado Implementation Defaults | launch_simulation_activehdl=0 | launch_simulation_ies=0
launch_simulation_modelsim=0 | launch_simulation_questa=0 | launch_simulation_riviera=0 | launch_simulation_vcs=0
launch_simulation_xsim=199 | simulator_language=Mixed | srcsetcount=5 | synthesisstrategy=Vivado Synthesis Defaults
target_language=VHDL | target_simulator=XSim | totalimplruns=1 | totalsynthesisruns=1

unisim_transformation

post_unisim_transformation
bufg=1 | carry4=165 | dna_port=1 | fdce=245
fdpe=2 | fdre=1619 | fdse=14 | gnd=5
ibuf=15 | lut1=138 | lut2=252 | lut3=379
lut4=374 | lut5=428 | lut6=1093 | muxf7=36
muxf8=4 | obuf=16 | ramb18e1=4 | ramb36e1=1

vcc=5

pre_unisim_transformation
bufg=1 | carry4=165 | dna_port=1 | fdce=245
fdpe=2 | fdre=1619 | fdse=14 | gnd=5
ibuf=15 | lut1=138 | lut2=252 | lut3=379
lut4=374 | lut5=428 | lut6=1093 | muxf7=36
muxf8=4 | obuf=16 | ramb18e1=4 | ramb36e1=1

vcc=5

phys_opt_design_post_place

command_line_options
-aggressive_hold_fix=default::[not_specified] | -bram_register_opt=default::[not_specified] | -clock_opt=default::[not_specified] | -critical_cell_opt=default::[not_specified]
-critical_pin_opt=default::[not_specified] | -directive=default::[not_specified] | -dsp_register_opt=default::[not_specified] | -effort_level=default::[not_specified]
-fanout_opt=default::[not_specified] | -hold_fix=default::[not_specified] | -insert_negative_edge_ffs=default::[not_specified] | -multi_clock_opt=default::[not_specified]
-placement_opt=default::[not_specified] | -restruct_opt=default::[not_specified] | -retime=default::[not_specified] | -rewire=default::[not_specified]
-shift_register_opt=default::[not_specified] | -uram_register_opt=default::[not_specified] | -verbose=default::[not_specified] | -vhfn=default::[not_specified]

power_opt_design

command_line_options_spo
-cell_types=default::all | -clocks=default::[not_specified] | -exclude_cells=default::[not_specified] | -include_cells=default::[not_specified]

usage
bram_ports_augmented=0 | bram_ports_newly_gated=2 | bram_ports_total=10 | flow_state=default
slice_registers_augmented=0 | slice_registers_newly_gated=0 | slice_registers_total=1690 | srls_augmented=0
srls_newly_gated=0 | srls_total=0

report_drc

command_line_options
-append=default::[not_specified] | -checks=default::[not_specified] | -fail_on=default::[not_specified] | -force=default::[not_specified]
-format=default::[not_specified] | -internal=default::[not_specified] | -internal_only=default::[not_specified] | -max_msgs_per_check=default::[not_specified]
-messages=default::[not_specified] | -name=default::[not_specified] | -no_waivers=default::[not_specified] | -return_string=default::[not_specified]
-ruledecks=default::[not_specified] | -upgrade_cw=default::[not_specified] | -waived=default::[not_specified]

results
cfgbvs-1=1 | reqp-1840=11

report_methodology

command_line_options
-append=default::[not_specified] | -checks=default::[not_specified] | -fail_on=default::[not_specified] | -force=default::[not_specified]
-format=default::[not_specified] | -messages=default::[not_specified] | -name=default::[not_specified] | -return_string=default::[not_specified]
-slack_lesser_than=default::[not_specified] | -waived=default::[not_specified]

results
ckld-2=1 | lutar-1=1 | timing-17=7 | timing-18=21

report_power

command_line_options
-advisory=default::[not_specified] | -append=default::[not_specified] | -file=[specified] | -format=default::text
-hier=default::power | -hierarchical_depth=default::4 | -l=default::[not_specified] | -name=default::[not_specified]
-no_propagation=default::[not_specified] | -return_string=default::[not_specified] | -rpx=[specified] | -verbose=default::[not_specified]
-vid=default::[not_specified] | -xpe=default::[not_specified]

usage
airflow=250 (LFM) | ambient_temp=25.0 (C) | bi-dir_toggle=12.500000 | bidir_output_enable=1.000000
board_layers=12to15 (12 to 15 Layers) | board_selection=medium (10"x10") | bram=0.003602 | clocks=0.005839
confidence_level_clock_activity=High | confidence_level_design_state=High | confidence_level_device_models=High | confidence_level_internal_activity=Medium
confidence_level_io_activity=Low | confidence_level_overall=Low | customer=TBD | customer_class=TBD
devstatic=0.061960 | die=xc7a35ticsg324-1L | dsp_output_toggle=12.500000 | dynamic=0.030115
effective_thetaja=4.78 | enable_probability=0.990000 | family=artix7 | ff_toggle=12.500000
flow_state=routed | heatsink=medium (Medium Profile) | i/o=0.007162 | input_toggle=12.500000
junction_temp=25.4 (C) | logic=0.006940 | mgtavcc_dynamic_current=0.000000 | mgtavcc_static_current=0.000000
mgtavcc_total_current=0.000000 | mgtavcc_voltage=1.000000 | mgtavtt_dynamic_current=0.000000 | mgtavtt_static_current=0.000000
mgtavtt_total_current=0.000000 | mgtavtt_voltage=1.200000 | netlist_net_matched=NA | off-chip_power=0.000000
on-chip_power=0.092075 | output_enable=1.000000 | output_load=5.000000 | output_toggle=12.500000
package=csg324 | pct_clock_constrained=2.000000 | pct_inputs_defined=8 | platform=nt64
process=typical | ram_enable=50.000000 | ram_write=50.000000 | read_saif=False
set/reset_probability=0.000000 | signal_rate=False | signals=0.006571 | simulation_file=None
speedgrade=-1L | static_prob=False | temp_grade=industrial | thetajb=6.8 (C/W)
thetasa=4.6 (C/W) | toggle_rate=False | user_board_temp=25.0 (C) | user_effective_thetaja=4.78
user_junc_temp=25.4 (C) | user_thetajb=6.8 (C/W) | user_thetasa=4.6 (C/W) | vccadc_dynamic_current=0.000000
vccadc_static_current=0.018000 | vccadc_total_current=0.018000 | vccadc_voltage=1.800000 | vccaux_dynamic_current=0.000248
vccaux_io_dynamic_current=0.000000 | vccaux_io_static_current=0.000000 | vccaux_io_total_current=0.000000 | vccaux_io_voltage=1.800000
vccaux_static_current=0.011356 | vccaux_total_current=0.011604 | vccaux_voltage=1.800000 | vccbram_dynamic_current=0.000292
vccbram_static_current=0.000135 | vccbram_total_current=0.000427 | vccbram_voltage=0.950000 | vccint_dynamic_current=0.024275
vccint_static_current=0.005991 | vccint_total_current=0.030266 | vccint_voltage=0.950000 | vcco12_dynamic_current=0.000000
vcco12_static_current=0.000000 | vcco12_total_current=0.000000 | vcco12_voltage=1.200000 | vcco135_dynamic_current=0.000000
vcco135_static_current=0.000000 | vcco135_total_current=0.000000 | vcco135_voltage=1.350000 | vcco15_dynamic_current=0.000000
vcco15_static_current=0.000000 | vcco15_total_current=0.000000 | vcco15_voltage=1.500000 | vcco18_dynamic_current=0.000000
vcco18_static_current=0.000000 | vcco18_total_current=0.000000 | vcco18_voltage=1.800000 | vcco25_dynamic_current=0.000000
vcco25_static_current=0.000000 | vcco25_total_current=0.000000 | vcco25_voltage=2.500000 | vcco33_dynamic_current=0.001918
vcco33_static_current=0.001000 | vcco33_total_current=0.002918 | vcco33_voltage=3.300000 | version=2020.2

report_utilization

clocking
bufgctrl_available=32 | bufgctrl_fixed=0 | bufgctrl_used=1 | bufgctrl_util_percentage=3.13
bufhce_available=72 | bufhce_fixed=0 | bufhce_used=0 | bufhce_util_percentage=0.00
bufio_available=20 | bufio_fixed=0 | bufio_used=0 | bufio_util_percentage=0.00
bufmrce_available=10 | bufmrce_fixed=0 | bufmrce_used=0 | bufmrce_util_percentage=0.00
bufr_available=20 | bufr_fixed=0 | bufr_used=0 | bufr_util_percentage=0.00
mmcme2_adv_available=5 | mmcme2_adv_fixed=0 | mmcme2_adv_used=0 | mmcme2_adv_util_percentage=0.00
plle2_adv_available=5 | plle2_adv_fixed=0 | plle2_adv_used=0 | plle2_adv_util_percentage=0.00

dsp
dsps_available=90 | dsps_fixed=0 | dsps_used=0 | dsps_util_percentage=0.00

io_standard
blvds_25=0 | diff_hstl_i=0 | diff_hstl_i_18=0 | diff_hstl_ii=0
diff_hstl_ii_18=0 | diff_hsul_12=0 | diff_mobile_ddr=0 | diff_sstl135=0
diff_sstl135_r=0 | diff_sstl15=0 | diff_sstl15_r=0 | diff_sstl18_i=0
diff_sstl18_ii=0 | hstl_i=0 | hstl_i_18=0 | hstl_ii=0
hstl_ii_18=0 | hsul_12=0 | lvcmos12=0 | lvcmos15=0
lvcmos18=0 | lvcmos25=0 | lvcmos33=1 | lvds_25=0
lvttl=0 | mini_lvds_25=0 | mobile_ddr=0 | pci33_3=0
ppds_25=0 | rsds_25=0 | sstl135=0 | sstl135_r=0
sstl15=0 | sstl15_r=0 | sstl18_i=0 | sstl18_ii=0

tmds_33=0

memory
block_ram_tile_available=50 | block_ram_tile_fixed=0 | block_ram_tile_used=3 | block_ram_tile_util_percentage=6.00
ramb18_available=100 | ramb18_fixed=0 | ramb18_used=4 | ramb18_util_percentage=4.00
ramb18e1_only_used=4 | ramb36_fifo_available=50 | ramb36_fifo_fixed=0 | ramb36_fifo_used=1
ramb36_fifo_util_percentage=2.00 | ramb36e1_only_used=1

primitives
bufg_functional_category=Clock | bufg_used=1 | carry4_functional_category=CarryLogic | carry4_used=157
dna_port_functional_category=Others | dna_port_used=1 | fdce_functional_category=Flop & Latch | fdce_used=247
fdpe_functional_category=Flop & Latch | fdpe_used=2 | fdre_functional_category=Flop & Latch | fdre_used=1430
fdse_functional_category=Flop & Latch | fdse_used=13 | ibuf_functional_category=IO | ibuf_used=12
lut1_functional_category=LUT | lut1_used=104 | lut2_functional_category=LUT | lut2_used=225
lut3_functional_category=LUT | lut3_used=365 | lut4_functional_category=LUT | lut4_used=356
lut5_functional_category=LUT | lut5_used=409 | lut6_functional_category=LUT | lut6_used=949
muxf7_functional_category=MuxFx | muxf7_used=33 | muxf8_functional_category=MuxFx | muxf8_used=4
obuf_functional_category=IO | obuf_used=16 | ramb18e1_functional_category=Block Memory | ramb18e1_used=4
ramb36e1_functional_category=Block Memory | ramb36e1_used=1 | zhold_delay_functional_category=Others | zhold_delay_used=6

slice_logic
f7_muxes_available=16300 | f7_muxes_fixed=0 | f7_muxes_used=33 | f7_muxes_util_percentage=0.20
f8_muxes_available=8150 | f8_muxes_fixed=0 | f8_muxes_used=4 | f8_muxes_util_percentage=0.05
lut_as_logic_available=20800 | lut_as_logic_fixed=0 | lut_as_logic_used=2026 | lut_as_logic_util_percentage=9.74
lut_as_memory_available=9600 | lut_as_memory_fixed=0 | lut_as_memory_used=0 | lut_as_memory_util_percentage=0.00
register_as_flip_flop_available=41600 | register_as_flip_flop_fixed=0 | register_as_flip_flop_used=1680 | register_as_flip_flop_util_percentage=4.04
register_as_latch_available=41600 | register_as_latch_fixed=0 | register_as_latch_used=0 | register_as_latch_util_percentage=0.00
slice_luts_available=20800 | slice_luts_fixed=0 | slice_luts_used=2026 | slice_luts_util_percentage=9.74
slice_registers_available=41600 | slice_registers_fixed=0 | slice_registers_used=1680 | slice_registers_util_percentage=4.04
lut_as_distributed_ram_fixed=0 | lut_as_distributed_ram_used=0 | lut_as_logic_available=20800 | lut_as_logic_fixed=0
lut_as_logic_used=2026 | lut_as_logic_util_percentage=9.74 | lut_as_memory_available=9600 | lut_as_memory_fixed=0
lut_as_memory_used=0 | lut_as_memory_util_percentage=0.00 | lut_as_shift_register_fixed=0 | lut_as_shift_register_used=0
lut_in_front_of_the_register_is_unused_fixed=0 | lut_in_front_of_the_register_is_unused_used=368 | lut_in_front_of_the_register_is_used_fixed=368 | lut_in_front_of_the_register_is_used_used=424
register_driven_from_outside_the_slice_fixed=424 | register_driven_from_outside_the_slice_used=792 | register_driven_from_within_the_slice_fixed=792 | register_driven_from_within_the_slice_used=888
slice_available=8150 | slice_fixed=0 | slice_registers_available=41600 | slice_registers_fixed=0
slice_registers_used=1680 | slice_registers_util_percentage=4.04 | slice_used=751 | slice_util_percentage=9.21
slicel_fixed=0 | slicel_used=482 | slicem_fixed=0 | slicem_used=269
unique_control_sets_available=8150 | unique_control_sets_fixed=8150 | unique_control_sets_used=187 | unique_control_sets_util_percentage=2.29
using_o5_and_o6_fixed=2.29 | using_o5_and_o6_used=382 | using_o5_output_only_fixed=382 | using_o5_output_only_used=0
using_o6_output_only_fixed=0 | using_o6_output_only_used=1644

specific_feature
bscane2_available=4 | bscane2_fixed=0 | bscane2_used=0 | bscane2_util_percentage=0.00
capturee2_available=1 | capturee2_fixed=0 | capturee2_used=0 | capturee2_util_percentage=0.00
dna_port_available=1 | dna_port_fixed=0 | dna_port_used=1 | dna_port_util_percentage=100.00
efuse_usr_available=1 | efuse_usr_fixed=0 | efuse_usr_used=0 | efuse_usr_util_percentage=0.00
frame_ecce2_available=1 | frame_ecce2_fixed=0 | frame_ecce2_used=0 | frame_ecce2_util_percentage=0.00
icape2_available=2 | icape2_fixed=0 | icape2_used=0 | icape2_util_percentage=0.00
pcie_2_1_available=1 | pcie_2_1_fixed=0 | pcie_2_1_used=0 | pcie_2_1_util_percentage=0.00
startupe2_available=1 | startupe2_fixed=0 | startupe2_used=0 | startupe2_util_percentage=0.00
xadc_available=1 | xadc_fixed=0 | xadc_used=0 | xadc_util_percentage=0.00

synthesis

command_line_options
-assert=default::[not_specified] | -bufg=default::12 | -cascade_dsp=default::auto | -constrset=default::[not_specified]
-control_set_opt_threshold=default::auto | -debug_log=default::[not_specified] | -directive=default::default | -fanout_limit=default::10000
-flatten_hierarchy=default::rebuilt | -fsm_extraction=default::auto | -gated_clock_conversion=default::off | -generic=default::[not_specified]
-include_dirs=default::[not_specified] | -keep_equivalent_registers=default::[not_specified] | -lint=default::[not_specified] | -max_bram=default::-1
-max_bram_cascade_height=default::-1 | -max_dsp=default::-1 | -max_uram=default::-1 | -max_uram_cascade_height=default::-1
-mode=default::default | -name=default::[not_specified] | -no_lc=default::[not_specified] | -no_srlextract=default::[not_specified]
-no_timing_driven=default::[not_specified] | -os=default::[not_specified] | -part=xc7a35ticsg324-1L | -resource_sharing=default::auto
-retiming=default::[not_specified] | -rtl=default::[not_specified] | -rtl_skip_constraints=default::[not_specified] | -rtl_skip_ip=default::[not_specified]
-seu_protect=default::none | -sfcu=default::[not_specified] | -shreg_min_size=default::3 | -top=artya7_35_spi2uart

-verilog_define=default::[not_specified]

usage
elapsed=00:00:49s | hls_ip=0 | memory_gain=31.133MB | memory_peak=1031.262MB

xsim

command_line_options
-sim_mode=post-implementation | -sim_type=timing
