iic-jku/SKY130_PLL1/Verilog/freqdiv/runs/RUN_2022.10.19_14.29.10/results/finishing/clock_divider.lef.spice

* NGSPICE file created from clock_divider.ext - technology: sky130A

* Black-box entry subcircuit for sky130_fd_sc_hd__conb_1 abstract view
.subckt sky130_fd_sc_hd__conb_1 VGND VNB VPB VPWR HI LO
.ends

* Black-box entry subcircuit for sky130_fd_sc_hd__decap_4 abstract view
.subckt sky130_fd_sc_hd__decap_4 VGND VNB VPB VPWR
.ends

* Black-box entry subcircuit for sky130_fd_sc_hd__dfxtp_1 abstract view
.subckt sky130_fd_sc_hd__dfxtp_1 CLK D VGND VNB VPB VPWR Q
.ends

* Black-box entry subcircuit for sky130_fd_sc_hd__decap_12 abstract view
.subckt sky130_fd_sc_hd__decap_12 VGND VNB VPB VPWR
.ends

* Black-box entry subcircuit for sky130_fd_sc_hd__decap_6 abstract view
.subckt sky130_fd_sc_hd__decap_6 VGND VNB VPB VPWR
.ends

* Black-box entry subcircuit for sky130_fd_sc_hd__or4_1 abstract view
.subckt sky130_fd_sc_hd__or4_1 A B C D VGND VNB VPB VPWR X
.ends

* Black-box entry subcircuit for sky130_fd_sc_hd__decap_8 abstract view
.subckt sky130_fd_sc_hd__decap_8 VGND VNB VPB VPWR
.ends

* Black-box entry subcircuit for sky130_fd_sc_hd__o21ba_1 abstract view
.subckt sky130_fd_sc_hd__o21ba_1 A1 A2 B1_N VGND VNB VPB VPWR X
.ends

* Black-box entry subcircuit for sky130_fd_sc_hd__nor3_1 abstract view
.subckt sky130_fd_sc_hd__nor3_1 A B C VGND VNB VPB VPWR Y
.ends

* Black-box entry subcircuit for sky130_fd_sc_hd__decap_3 abstract view
.subckt sky130_fd_sc_hd__decap_3 VGND VNB VPB VPWR
.ends

* Black-box entry subcircuit for sky130_fd_sc_hd__fill_1 abstract view
.subckt sky130_fd_sc_hd__fill_1 VGND VNB VPB VPWR
.ends

* Black-box entry subcircuit for sky130_fd_sc_hd__fill_2 abstract view
.subckt sky130_fd_sc_hd__fill_2 VGND VNB VPB VPWR
.ends

* Black-box entry subcircuit for sky130_fd_sc_hd__buf_4 abstract view
.subckt sky130_fd_sc_hd__buf_4 A VGND VNB VPB VPWR X
.ends

* Black-box entry subcircuit for sky130_fd_sc_hd__a21oi_1 abstract view
.subckt sky130_fd_sc_hd__a21oi_1 A1 A2 B1 VGND VNB VPB VPWR Y
.ends

* Black-box entry subcircuit for sky130_fd_sc_hd__nor2_1 abstract view
.subckt sky130_fd_sc_hd__nor2_1 A B VGND VNB VPB VPWR Y
.ends

* Black-box entry subcircuit for sky130_fd_sc_hd__xnor2_1 abstract view
.subckt sky130_fd_sc_hd__xnor2_1 A B VGND VNB VPB VPWR Y
.ends

* Black-box entry subcircuit for sky130_fd_sc_hd__dfxtp_2 abstract view
.subckt sky130_fd_sc_hd__dfxtp_2 CLK D VGND VNB VPB VPWR Q
.ends

* Black-box entry subcircuit for sky130_fd_sc_hd__tapvpwrvgnd_1 abstract view
.subckt sky130_fd_sc_hd__tapvpwrvgnd_1 VGND VPWR
.ends

* Black-box entry subcircuit for sky130_fd_sc_hd__or3_1 abstract view
.subckt sky130_fd_sc_hd__or3_1 A B C VGND VNB VPB VPWR X
.ends

* Black-box entry subcircuit for sky130_fd_sc_hd__a31o_1 abstract view
.subckt sky130_fd_sc_hd__a31o_1 A1 A2 A3 B1 VGND VNB VPB VPWR X
.ends

* Black-box entry subcircuit for sky130_fd_sc_hd__and3_1 abstract view
.subckt sky130_fd_sc_hd__and3_1 A B C VGND VNB VPB VPWR X
.ends

* Black-box entry subcircuit for sky130_fd_sc_hd__buf_6 abstract view
.subckt sky130_fd_sc_hd__buf_6 A VGND VNB VPB VPWR X
.ends

* Black-box entry subcircuit for sky130_fd_sc_hd__or2_1 abstract view
.subckt sky130_fd_sc_hd__or2_1 A B VGND VNB VPB VPWR X
.ends

.subckt clock_divider VGND VPWR clock_in clock_out
X_098__10 VGND VGND VPWR VPWR _098__10/HI _082_/D sky130_fd_sc_hd__conb_1
XFILLER_12_10 VGND VGND VPWR VPWR sky130_fd_sc_hd__decap_4
XFILLER_3_12 VGND VGND VPWR VPWR sky130_fd_sc_hd__decap_4
X_062_ input1/X _062_/D VGND VGND VPWR VPWR _062_/Q sky130_fd_sc_hd__dfxtp_1
XFILLER_0_24 VGND VGND VPWR VPWR sky130_fd_sc_hd__decap_4
XFILLER_0_57 VGND VGND VPWR VPWR sky130_fd_sc_hd__decap_12
XFILLER_13_3 VGND VGND VPWR VPWR sky130_fd_sc_hd__decap_6
XFILLER_6_78 VGND VGND VPWR VPWR sky130_fd_sc_hd__decap_6
X_045_ _089_/Q _088_/Q _087_/Q _086_/Q VGND VGND VPWR VPWR _046_/B sky130_fd_sc_hd__or4_1
XFILLER_3_46 VGND VGND VPWR VPWR sky130_fd_sc_hd__decap_8
XFILLER_12_66 VGND VGND VPWR VPWR sky130_fd_sc_hd__decap_4
XFILLER_9_45 VGND VGND VPWR VPWR sky130_fd_sc_hd__decap_4
X_061_ _065_/Q _060_/A _060_/B VGND VGND VPWR VPWR _065_/D sky130_fd_sc_hd__o21ba_1
X_044_ _079_/Q _078_/Q _081_/Q _080_/Q VGND VGND VPWR VPWR _046_/A sky130_fd_sc_hd__or4_1
X_091__3 VGND VGND VPWR VPWR _091__3/HI _089_/D sky130_fd_sc_hd__conb_1
XFILLER_0_69 VGND VGND VPWR VPWR sky130_fd_sc_hd__decap_12
XFILLER_6_24 VGND VGND VPWR VPWR sky130_fd_sc_hd__decap_4
XFILLER_0_37 VGND VGND VPWR VPWR sky130_fd_sc_hd__decap_8
X_060_ _060_/A _060_/B _060_/C VGND VGND VPWR VPWR _064_/D sky130_fd_sc_hd__nor3_1
XFILLER_3_3 VGND VGND VPWR VPWR sky130_fd_sc_hd__decap_6
X_043_ _073_/Q _072_/Q _071_/Q _070_/Q VGND VGND VPWR VPWR _053_/A sky130_fd_sc_hd__or4_1
XFILLER_6_58 VGND VGND VPWR VPWR sky130_fd_sc_hd__decap_4
X_113__25 VGND VGND VPWR VPWR _113__25/HI _067_/D sky130_fd_sc_hd__conb_1
XFILLER_12_46 VGND VGND VPWR VPWR sky130_fd_sc_hd__decap_4
XFILLER_12_24 VGND VGND VPWR VPWR sky130_fd_sc_hd__decap_4
XFILLER_3_26 VGND VGND VPWR VPWR sky130_fd_sc_hd__decap_4
XFILLER_5_7 VGND VGND VPWR VPWR sky130_fd_sc_hd__decap_4
XFILLER_9_25 VGND VGND VPWR VPWR sky130_fd_sc_hd__decap_4
XFILLER_0_49 VGND VGND VPWR VPWR sky130_fd_sc_hd__decap_6
X_104__16 VGND VGND VPWR VPWR _104__16/HI _076_/D sky130_fd_sc_hd__conb_1
XFILLER_6_38 VGND VGND VPWR VPWR sky130_fd_sc_hd__decap_4
X_094__6 VGND VGND VPWR VPWR _094__6/HI _086_/D sky130_fd_sc_hd__conb_1
XFILLER_1_3 VGND VGND VPWR VPWR sky130_fd_sc_hd__decap_12
XFILLER_0_29 VGND VGND VPWR VPWR sky130_fd_sc_hd__decap_4
XFILLER_10_70 VGND VGND VPWR VPWR sky130_fd_sc_hd__decap_4
XPHY_0 VGND VGND VPWR VPWR sky130_fd_sc_hd__decap_3
XFILLER_13_81 VGND VGND VPWR VPWR sky130_fd_sc_hd__decap_8
XFILLER_1_62 VGND VGND VPWR VPWR sky130_fd_sc_hd__decap_12
XFILLER_13_9 VGND VGND VPWR VPWR sky130_fd_sc_hd__fill_1
XFILLER_11_6 VGND VGND VPWR VPWR sky130_fd_sc_hd__decap_4
XFILLER_6_29 VGND VGND VPWR VPWR sky130_fd_sc_hd__fill_2
XPHY_1 VGND VGND VPWR VPWR sky130_fd_sc_hd__decap_3
XFILLER_12_17 VGND VGND VPWR VPWR sky130_fd_sc_hd__decap_4
XFILLER_3_19 VGND VGND VPWR VPWR sky130_fd_sc_hd__decap_4
XFILLER_10_83 VGND VGND VPWR VPWR sky130_fd_sc_hd__fill_1
XFILLER_10_50 VGND VGND VPWR VPWR sky130_fd_sc_hd__decap_4
XFILLER_1_74 VGND VGND VPWR VPWR sky130_fd_sc_hd__decap_12
XFILLER_7_84 VGND VGND VPWR VPWR sky130_fd_sc_hd__decap_4
XFILLER_7_73 VGND VGND VPWR VPWR sky130_fd_sc_hd__decap_4
XPHY_2 VGND VGND VPWR VPWR sky130_fd_sc_hd__decap_3
XFILLER_12_29 VGND VGND VPWR VPWR sky130_fd_sc_hd__fill_1
XFILLER_4_85 VGND VGND VPWR VPWR sky130_fd_sc_hd__decap_4
XFILLER_1_86 VGND VGND VPWR VPWR sky130_fd_sc_hd__decap_3
X_097__9 VGND VGND VPWR VPWR _097__9/HI _083_/D sky130_fd_sc_hd__conb_1
XFILLER_7_52 VGND VGND VPWR VPWR sky130_fd_sc_hd__decap_4
XPHY_3 VGND VGND VPWR VPWR sky130_fd_sc_hd__decap_3
X_100__12 VGND VGND VPWR VPWR _100__12/HI _080_/D sky130_fd_sc_hd__conb_1
XFILLER_13_62 VGND VGND VPWR VPWR sky130_fd_sc_hd__decap_4
XFILLER_10_85 VGND VGND VPWR VPWR sky130_fd_sc_hd__decap_4
XFILLER_1_54 VGND VGND VPWR VPWR sky130_fd_sc_hd__fill_2
XPHY_4 VGND VGND VPWR VPWR sky130_fd_sc_hd__decap_3
X_079_ input1/X _079_/D VGND VGND VPWR VPWR _079_/Q sky130_fd_sc_hd__dfxtp_1
X_078_ input1/X _078_/D VGND VGND VPWR VPWR _078_/Q sky130_fd_sc_hd__dfxtp_1
X_107__19 VGND VGND VPWR VPWR _107__19/HI _073_/D sky130_fd_sc_hd__conb_1
XFILLER_7_32 VGND VGND VPWR VPWR sky130_fd_sc_hd__decap_4
XPHY_5 VGND VGND VPWR VPWR sky130_fd_sc_hd__decap_3
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
Xoutput2 _090_/Q VGND VGND VPWR VPWR clock_out sky130_fd_sc_hd__buf_6
X_083_ input1/X _083_/D VGND VGND VPWR VPWR _083_/Q sky130_fd_sc_hd__dfxtp_1
XFILLER_3_74 VGND VGND VPWR VPWR sky130_fd_sc_hd__decap_4
XFILLER_9_73 VGND VGND VPWR VPWR sky130_fd_sc_hd__decap_4
X_049_ _083_/Q _082_/Q _085_/Q _084_/Q VGND VGND VPWR VPWR _050_/C sky130_fd_sc_hd__or4_1
X_066_ input1/X _066_/D VGND VGND VPWR VPWR _066_/Q sky130_fd_sc_hd__dfxtp_1
XFILLER_14_29 VGND VGND VPWR VPWR sky130_fd_sc_hd__decap_4
XPHY_28 VGND VGND VPWR VPWR sky130_fd_sc_hd__decap_3
XPHY_17 VGND VGND VPWR VPWR sky130_fd_sc_hd__decap_3
XFILLER_6_85 VGND VGND VPWR VPWR sky130_fd_sc_hd__decap_4
X_110__22 VGND VGND VPWR VPWR _110__22/HI _070_/D sky130_fd_sc_hd__conb_1
X_082_ input1/X _082_/D VGND VGND VPWR VPWR _082_/Q sky130_fd_sc_hd__dfxtp_1
X_065_ input1/X _065_/D VGND VGND VPWR VPWR _065_/Q sky130_fd_sc_hd__dfxtp_1
X_048_ _077_/Q _076_/Q _075_/Q _074_/Q VGND VGND VPWR VPWR _050_/B sky130_fd_sc_hd__or4_1
XFILLER_9_52 VGND VGND VPWR VPWR sky130_fd_sc_hd__decap_4
XPHY_29 VGND VGND VPWR VPWR sky130_fd_sc_hd__decap_3
XPHY_18 VGND VGND VPWR VPWR sky130_fd_sc_hd__decap_3
XFILLER_12_85 VGND VGND VPWR VPWR sky130_fd_sc_hd__decap_4
XFILLER_12_74 VGND VGND VPWR VPWR sky130_fd_sc_hd__decap_8
X_081_ input1/X _081_/D VGND VGND VPWR VPWR _081_/Q sky130_fd_sc_hd__dfxtp_1
XFILLER_3_54 VGND VGND VPWR VPWR sky130_fd_sc_hd__fill_2
X_064_ input1/X _064_/D VGND VGND VPWR VPWR _064_/Q sky130_fd_sc_hd__dfxtp_1
XFILLER_0_33 VGND VGND VPWR VPWR sky130_fd_sc_hd__fill_1
XFILLER_0_55 VGND VGND VPWR VPWR sky130_fd_sc_hd__fill_1
XPHY_19 VGND VGND VPWR VPWR sky130_fd_sc_hd__decap_3
X_047_ _069_/Q _068_/Q _066_/Q _067_/Q VGND VGND VPWR VPWR _050_/A sky130_fd_sc_hd__or4_1
X_101__13 VGND VGND VPWR VPWR _101__13/HI _079_/D sky130_fd_sc_hd__conb_1
X_063_ input1/X _063_/D VGND VGND VPWR VPWR _063_/Q sky130_fd_sc_hd__dfxtp_1
XFILLER_5_3 VGND VGND VPWR VPWR sky130_fd_sc_hd__fill_1
X_080_ input1/X _080_/D VGND VGND VPWR VPWR _080_/Q sky130_fd_sc_hd__dfxtp_1
XFILLER_0_12 VGND VGND VPWR VPWR sky130_fd_sc_hd__decap_12
X_046_ _046_/A _046_/B VGND VGND VPWR VPWR _055_/A sky130_fd_sc_hd__or2_1
.ends
