iic-jku/SKY130_PLL1/eval/SKY130_PLL_eval_PCB/SKY130_PLL_eval.kicad_pcb

## KiCad design eval/SKY130_PLL_eval_PCB/SKY130_PLL_eval.kicad_pcb (2024-04-09)

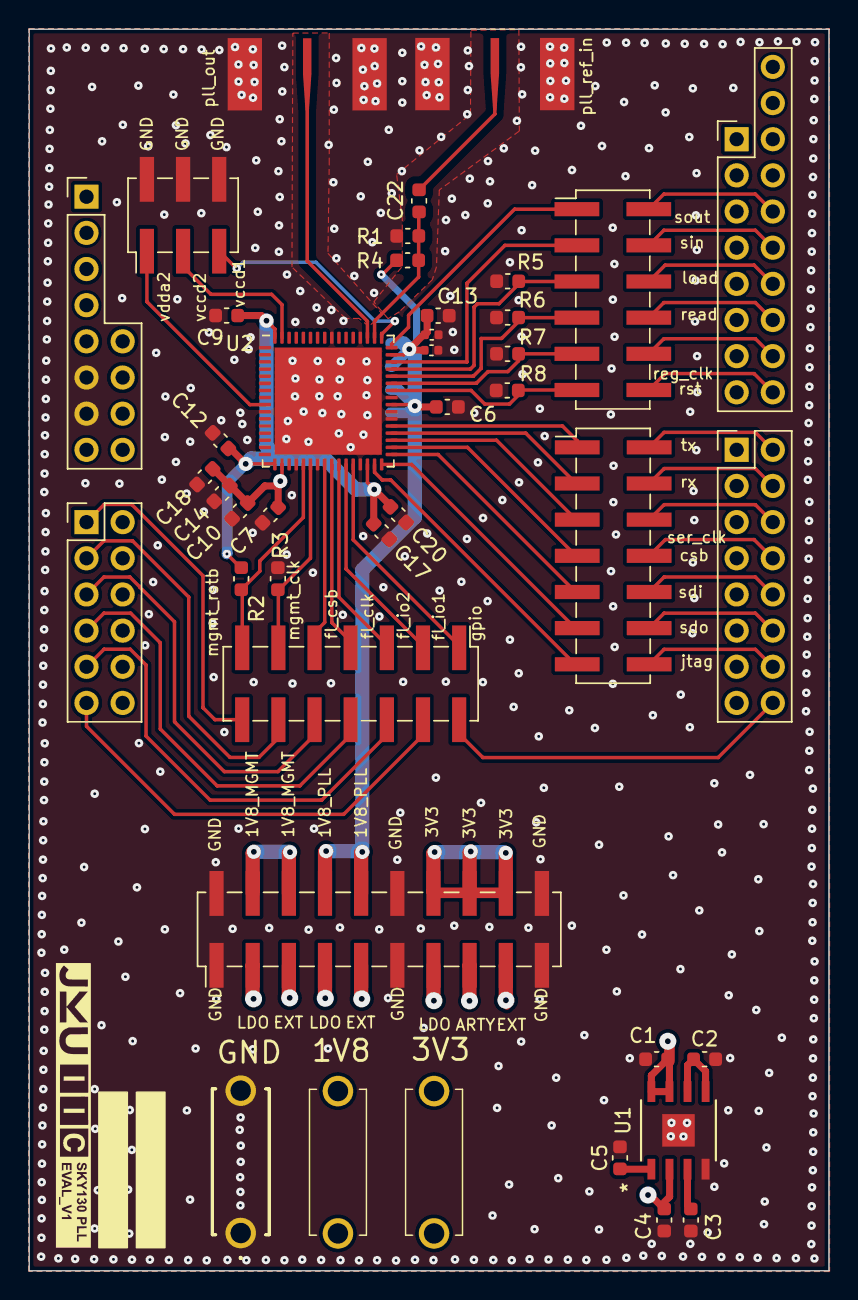
[picture p26: board SKY130_PLL_eval.kicad_pcb from above]

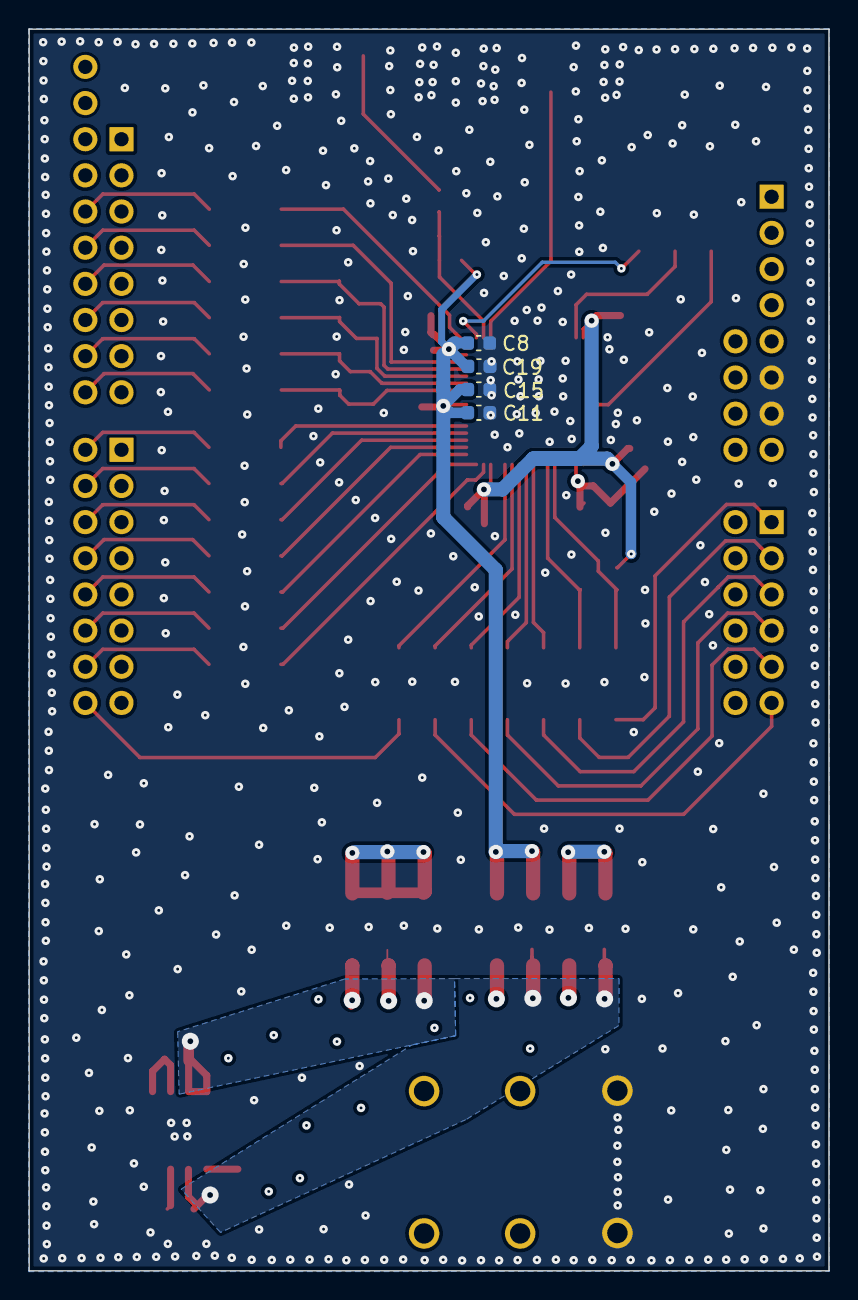
[picture p27: board SKY130_PLL_eval.kicad_pcb from below]

Board: 4 copper layers, 56.2 x 87.2 mm, 43 parts (4 on the bottom side), 58 nets.

Parts:
C1, C4, C5, C7, C8, C9: 10u; C_0603_1608Metric
C2, C3, C14, C15, C17: 1u; C_0603_1608Metric
C6: 10n; C_0603_1608Metric
C10, C11, C12: 4.7u; C_0603_1608Metric
C13, C22: 1n; C_0603_1608Metric
C16: 82p; C_0402_1005Metric
C18, C19, C20: 100n; C_0603_1608Metric
C21: 68p; C_0402_1005Metric
J1: Conn_02x10_Odd_Even; PinHeader_2x10_P2.54mm_Vertical_SMD
J2: Conn_02x03_Odd_Even; PinHeader_2x03_P2.54mm_Vertical_SMD
J3, J5: Conn_02x07_Odd_Even; PinHeader_2x07_P2.54mm_Vertical_SMD
J6: Conn_02x06_Odd_Even; PinHeader_2x06_P2.54mm_Vertical_SMD
J_PLL_OUT1: 142-0701-851_TO_SENSO1
J_PLL_REF_IN1: 142-0701-851_TO_SENSO1
R1, R4: 100; C_0603_1608Metric
R2, R3, R5, R6, R7, R8: 100k; C_0603_1608Metric
TP1V8, TP3V3: Mini_Banana_Plug_Red; 930224101
TPGND1: Mini_Banana_Plug_Black; 930224100
U1: ADM7154ARDZ-1.8-R7; RD-8-1_ADI
U2: Caravel_QFN; QFN-64-1EP_9x9mm_P0.5mm_EP7.65x7.65mm
XA1: Arty_A7_Shield

Connections:
/IC_Packaged/flash_clk: J3.7, U2.25 (flash_clk)
/IC_Packaged/flash_csb: J3.9, U2.24 (flash_csb)
/IC_Packaged/flash_io1: J3.3, U2.27 (flash_io1)
/IC_Packaged/flash_io2: J3.5, U2.26 (flash_io0)
/IC_Packaged/gpio: J3.1, U2.28 (gpio)
/IC_Packaged/mgmt_clk: J3.11, R3.1, U2.22 (clock)
/IC_Packaged/mgmt_rstb: J3.13, R2.2, U2.21 (resetb)
/IC_Packaged/pll_load: J6.5, R5.1, U2.45 (mprj_io[11])
/IC_Packaged/pll_read: J6.7, R6.1, U2.44 (mprj_io[10])
/IC_Packaged/pll_reg_clk_in: J6.9, R7.1, U2.43 (mprj_io[9])
/IC_Packaged/pll_reset: J6.11, R8.1, U2.42 (mprj_io[8])
/IC_Packaged/pll_sin: J6.3, U2.46 (mprj_io[12])
/IC_Packaged/pll_sout: J6.1, U2.48 (mprj_io[13])
/IC_Packaged/ser_clk: J5.5, U2.35 (mprj_io[4]_SCK)
/IC_Packaged/ser_csb: J5.7, U2.34 (mprj_io[3]_CSB)
/IC_Packaged/ser_jtag: J5.13, U2.31 (mprj_io[0]_JTAG)
/IC_Packaged/ser_rx: J5.3, U2.36 (mprj_io[5]_ser_rx)
/IC_Packaged/ser_sdi: J5.9, U2.33 (mprj_io[2]_SDI)
/IC_Packaged/ser_sdo: J5.11, U2.32 (mprj_io[1]_SDO)
/IC_Packaged/ser_tx: J5.1, U2.37 (mprj_io[6]_ser_tx)
/IC_Packaged/vccd1: J2.5, U2.49 (vccd1)
/IC_Packaged/vccd2: J2.3, U2.63 (vccd2)
/IC_Packaged/vdda2: J2.1, U2.9 (vdda2)
/PLL_IO/pll_sma_in: C22.1, J_PLL_REF_IN1.1
/Power/LDO_BYP: C3.1, U1.3 (BYP)
/Power/LDO_REF: C2.1, U1.5 (REF_SENSE), U1.6 (REF)
/Power/LDO_VREG: C5.1, U1.1 (VREG)
/Power/VDD_1V8_EXT: J1.5, J1.9, TP1V8.1, TP1V8.2
/Power/VDD_1V8_LDO: C4.1, J1.3, J1.7, U1.2 (VOUT)
/Power/VDD_3V3_EXT: J1.17, TP3V3.1, TP3V3.2
/Power/VDD_3V3_LDO: C1.1, J1.13, U1.7 (EN), U1.8 (VIN)
GND: C1.2, C2.2, C3.2, C4.2, C5.2, C6.2, C7.2, C8.2, C9.2, C10.2, C11.2, C12.2, C13.2, C14.2, C15.2, C16.2, C17.2, C18.2, C19.2, C20.2, C21.2, J1.1, J1.2, J1.11, J1.12, J1.19, J1.20, J2.2, J2.4, J2.6, J_PLL_OUT1.2, J_PLL_OUT1.3, J_PLL_REF_IN1.2, J_PLL_REF_IN1.3, R1.2, R3.2, R5.2, R6.2, R7.2, R8.2, TPGND1.1, TPGND1.2, U1.4 (GND), U1.9 (GND), U2.1 (vssa2), U2.10 (vssd2), U2.20 (vssa), U2.23 (vssd), U2.29 (vssio), U2.38 (vssa1), U2.39 (vssd1), U2.41 (mprj_io[7]), U2.52 (vssa1), U2.56 (vssio), U2.65 (ThermalPad), XA1.GND0 (GND), XA1.GND1 (GND)
VDD_1V8_MGMT: C7.1, C10.1, C14.1, C18.1, J1.4, J1.6, U2.18 (vccd)
VDD_1V8_PLL: C6.1, C8.1, C11.1, C13.1, C15.1, C16.1, C19.1, C21.1, J1.8, J1.10, R4.1, U2.40 (vdda1), U2.47 (vdda1)
VDD_3V3: C9.1, C12.1, C17.1, C20.1, J1.14, J1.16, J1.18, R2.1, U2.17 (vddio), U2.30 (vdda), U2.64 (vddio)
VDD_3V3_ARTY: J1.15, XA1.3V3 (3.3V)
flash_clk_arty: J3.8, XA1.A3
flash_csb_arty: J3.10, XA1.A2
flash_io1_arty: J3.4, XA1.A5
flash_io2_arty: J3.6, XA1.A4
gpio_arty: J3.2, XA1.IO0
mgmt_clk_arty: J3.12, XA1.A1
mgmt_rstb_arty: J3.14, XA1.A0
pll_load_arty: J6.6, XA1.IO11
pll_out: J_PLL_OUT1.1, U2.51 (mprj_io[15])
pll_read_arty: J6.8, XA1.IO10
pll_ref_in: C22.2, R1.1, R4.2, U2.50 (mprj_io[14])
pll_reg_clk_in_arty: J6.10, XA1.IO9
pll_reset_arty: J6.12, XA1.IO8
pll_sin_arty: J6.4, XA1.IO12
pll_sout_arty: J6.2, XA1.IO13
ser_clk_arty: J5.6, XA1.IO5
ser_csb_arty: J5.8, XA1.IO4
ser_jtag_arty: J5.14, XA1.IO1
ser_rx_arty: J5.4, XA1.IO6
ser_sdi_arty: J5.10, XA1.IO3
ser_sdo_arty: J5.12, XA1.IO2
ser_tx_arty: J5.2, XA1.IO7
