iic-jku/SKY130_PLL1/eval/digital_configuration/sky130_pll_controller/s1_SPI_Master.runs/synth_1/.Xil/artya7_35_spi2uart_propImpl.xdc

set_property SRC_FILE_INFO {cfile:C:/Users/fath_local/Desktop/pico_contest/SKY130_PLL1/eval/digital_configuration/sky130_pll_controller/s1_SPI_Master.srcs/constrs_1/Arty-A7-35-Master.xdc rfile:../../../s1_SPI_Master.srcs/constrs_1/Arty-A7-35-Master.xdc id:1} [current_design]
set_property src_info {type:XDC file:1 line:7 export:INPUT save:INPUT read:READ} [current_design]
set_property -dict { PACKAGE_PIN E3    IOSTANDARD LVCMOS33 } [get_ports { CLK100MHZ }];
set_property src_info {type:XDC file:1 line:14 export:INPUT save:INPUT read:READ} [current_design]
set_property -dict { PACKAGE_PIN A10   IOSTANDARD LVCMOS33 } [get_ports { SW_1MCLK_EN }]; #IO_L14P_T2_SRCC_16 Sch=sw[3]
set_property src_info {type:XDC file:1 line:37 export:INPUT save:INPUT read:READ} [current_design]
set_property -dict { PACKAGE_PIN D9    IOSTANDARD LVCMOS33 } [get_ports { BTN_RST }]; #IO_L6N_T0_VREF_16 Sch=btn[0]
set_property src_info {type:XDC file:1 line:96 export:INPUT save:INPUT read:READ} [current_design]
set_property -dict { PACKAGE_PIN N15 IOSTANDARD LVCMOS33 } [get_ports { reset_to_chip }];      #IO_L11P_T1_SRCC_14 Sch=ck_io[8]
set_property src_info {type:XDC file:1 line:97 export:INPUT save:INPUT read:READ} [current_design]
set_property -dict { PACKAGE_PIN M16 IOSTANDARD LVCMOS33 } [get_ports { REG_CLK }];             #IO_L10P_T1_D14_14 Sch=ck_io[9]
set_property src_info {type:XDC file:1 line:98 export:INPUT save:INPUT read:READ} [current_design]
set_property -dict { PACKAGE_PIN V17 IOSTANDARD LVCMOS33 } [get_ports { READ }];                 #IO_L18N_T2_A11_D27_14 Sch=ck_io[10]
set_property src_info {type:XDC file:1 line:99 export:INPUT save:INPUT read:READ} [current_design]
set_property -dict { PACKAGE_PIN U18 IOSTANDARD LVCMOS33 } [get_ports { LOAD }];               #IO_L17N_T2_A13_D29_14 Sch=ck_io[11]
set_property src_info {type:XDC file:1 line:100 export:INPUT save:INPUT read:READ} [current_design]
set_property -dict {PACKAGE_PIN R17 IOSTANDARD LVCMOS33} [get_ports { SIN }];               #IO_L12N_T1_MRCC_14 Sch=ck_io[12]
set_property src_info {type:XDC file:1 line:101 export:INPUT save:INPUT read:READ} [current_design]
set_property -dict {PACKAGE_PIN P17 IOSTANDARD LVCMOS33} [get_ports { SOUT }];               #IO_L12P_T1_MRCC_14 Sch=ck_io[13]
set_property src_info {type:XDC file:1 line:107 export:INPUT save:INPUT read:READ} [current_design]
set_property -dict { PACKAGE_PIN R11   IOSTANDARD LVCMOS33 } [get_ports { PIN3_i }]; #IO_0_14  		 			Sch=ck_io[30]
set_property src_info {type:XDC file:1 line:108 export:INPUT save:INPUT read:READ} [current_design]
set_property -dict { PACKAGE_PIN R13   IOSTANDARD LVCMOS33 } [get_ports { PIN2_o }]; #IO_L5N_T0_D07_14 			Sch=ck_io[31]
set_property src_info {type:XDC file:1 line:109 export:INPUT save:INPUT read:READ} [current_design]
set_property -dict { PACKAGE_PIN R15   IOSTANDARD LVCMOS33 } [get_ports { PIN1_o }]; #IO_L13N_T2_MRCC_14 			Sch=ck_io[32]
set_property src_info {type:XDC file:1 line:138 export:INPUT save:INPUT read:READ} [current_design]
set_property -dict { PACKAGE_PIN F5    IOSTANDARD LVCMOS33 } [get_ports { reset_to_chip_mgmt }]; #IO_0_35           	Sch=ck_a[0]		ChipKit pin=A0
set_property src_info {type:XDC file:1 line:139 export:INPUT save:INPUT read:READ} [current_design]
set_property -dict { PACKAGE_PIN D8    IOSTANDARD LVCMOS33 } [get_ports { CLK_1M_OUT }]; #IO_L4P_T0_35      	Sch=ck_a[1]		ChipKit pin=A1
set_property src_info {type:XDC file:1 line:181 export:INPUT save:INPUT read:READ} [current_design]
set_property -dict {PACKAGE_PIN D17 IOSTANDARD LVCMOS33} [get_ports { eth_col }];
set_property src_info {type:XDC file:1 line:182 export:INPUT save:INPUT read:READ} [current_design]
set_property -dict {PACKAGE_PIN G14 IOSTANDARD LVCMOS33} [get_ports { eth_crs }];
set_property src_info {type:XDC file:1 line:183 export:INPUT save:INPUT read:READ} [current_design]
set_property -dict {PACKAGE_PIN F16 IOSTANDARD LVCMOS33} [get_ports { eth_mdc }];
set_property src_info {type:XDC file:1 line:184 export:INPUT save:INPUT read:READ} [current_design]
set_property -dict {PACKAGE_PIN K13 IOSTANDARD LVCMOS33} [get_ports { eth_mdio }];
set_property src_info {type:XDC file:1 line:185 export:INPUT save:INPUT read:READ} [current_design]
set_property -dict {PACKAGE_PIN G18 IOSTANDARD LVCMOS33} [get_ports { eth_ref_clk }];
set_property src_info {type:XDC file:1 line:186 export:INPUT save:INPUT read:READ} [current_design]
set_property -dict {PACKAGE_PIN C16 IOSTANDARD LVCMOS33} [get_ports { eth_rstn }];
set_property src_info {type:XDC file:1 line:187 export:INPUT save:INPUT read:READ} [current_design]
set_property -dict {PACKAGE_PIN F15 IOSTANDARD LVCMOS33} [get_ports { eth_rx_clk }];
set_property src_info {type:XDC file:1 line:188 export:INPUT save:INPUT read:READ} [current_design]
set_property -dict {PACKAGE_PIN G16 IOSTANDARD LVCMOS33} [get_ports { eth_rx_dv }];
set_property src_info {type:XDC file:1 line:189 export:INPUT save:INPUT read:READ} [current_design]
set_property -dict {PACKAGE_PIN D18 IOSTANDARD LVCMOS33} [get_ports { eth_rxd[0] }];
set_property src_info {type:XDC file:1 line:190 export:INPUT save:INPUT read:READ} [current_design]
set_property -dict {PACKAGE_PIN E17 IOSTANDARD LVCMOS33} [get_ports { eth_rxd[1] }];
set_property src_info {type:XDC file:1 line:191 export:INPUT save:INPUT read:READ} [current_design]
set_property -dict {PACKAGE_PIN E18 IOSTANDARD LVCMOS33} [get_ports { eth_rxd[2] }];
set_property src_info {type:XDC file:1 line:192 export:INPUT save:INPUT read:READ} [current_design]
set_property -dict {PACKAGE_PIN G17 IOSTANDARD LVCMOS33} [get_ports { eth_rxd[3] }];
set_property src_info {type:XDC file:1 line:193 export:INPUT save:INPUT read:READ} [current_design]
set_property -dict {PACKAGE_PIN C17 IOSTANDARD LVCMOS33} [get_ports { eth_rxerr }];
set_property src_info {type:XDC file:1 line:194 export:INPUT save:INPUT read:READ} [current_design]
set_property -dict {PACKAGE_PIN H16 IOSTANDARD LVCMOS33} [get_ports { eth_tx_clk }];
set_property src_info {type:XDC file:1 line:195 export:INPUT save:INPUT read:READ} [current_design]
set_property -dict {PACKAGE_PIN H15 IOSTANDARD LVCMOS33} [get_ports { eth_tx_en }];
set_property src_info {type:XDC file:1 line:196 export:INPUT save:INPUT read:READ} [current_design]
set_property -dict {PACKAGE_PIN H14 IOSTANDARD LVCMOS33} [get_ports { eth_txd[0] }];
set_property src_info {type:XDC file:1 line:197 export:INPUT save:INPUT read:READ} [current_design]
set_property -dict {PACKAGE_PIN J14 IOSTANDARD LVCMOS33} [get_ports { eth_txd[1] }];
set_property src_info {type:XDC file:1 line:198 export:INPUT save:INPUT read:READ} [current_design]
set_property -dict {PACKAGE_PIN J13 IOSTANDARD LVCMOS33} [get_ports { eth_txd[2] }];
set_property src_info {type:XDC file:1 line:199 export:INPUT save:INPUT read:READ} [current_design]
set_property -dict {PACKAGE_PIN H17 IOSTANDARD LVCMOS33} [get_ports { eth_txd[3] }];
