iic-jku/SKY130_PLL1/PICO Contest/pin_dummy/verilog/gl/pin_dummy.v

module pin_dummy (VGND,
    VPWR,
    avdd,
    avss,
    clk,
    cvdd,
    cvss,
    dvdd,
    dvss,
    load,
    out,
    read,
    ref,
    s_in,
    s_out);
 input VGND;
 input VPWR;
 input avdd;
 input avss;
 input clk;
 input cvdd;
 input cvss;
 input dvdd;
 input dvss;
 input load;
 output out;
 input read;
 input ref;
 input s_in;
 output s_out;

 wire net1;
 wire net2;

 sky130_fd_sc_hd__decap_12 FILLER_0_15 (.VGND(VGND),
    .VNB(VGND),
    .VPB(VPWR),
    .VPWR(VPWR));
 sky130_fd_sc_hd__fill_1 FILLER_0_27 (.VGND(VGND),
    .VNB(VGND),
    .VPB(VPWR),
    .VPWR(VPWR));
 sky130_fd_sc_hd__decap_12 FILLER_0_29 (.VGND(VGND),
    .VNB(VGND),
    .VPB(VPWR),
    .VPWR(VPWR));
 sky130_fd_sc_hd__decap_12 FILLER_0_3 (.VGND(VGND),
    .VNB(VGND),
    .VPB(VPWR),
    .VPWR(VPWR));
 sky130_fd_sc_hd__decap_12 FILLER_0_41 (.VGND(VGND),
    .VNB(VGND),
    .VPB(VPWR),
    .VPWR(VPWR));
 sky130_fd_sc_hd__decap_3 FILLER_0_53 (.VGND(VGND),
    .VNB(VGND),
    .VPB(VPWR),
    .VPWR(VPWR));
 sky130_fd_sc_hd__decap_12 FILLER_1_15 (.VGND(VGND),
    .VNB(VGND),
    .VPB(VPWR),
    .VPWR(VPWR));
 sky130_fd_sc_hd__decap_12 FILLER_1_27 (.VGND(VGND),
    .VNB(VGND),
    .VPB(VPWR),
    .VPWR(VPWR));
 sky130_fd_sc_hd__decap_12 FILLER_1_3 (.VGND(VGND),
    .VNB(VGND),
    .VPB(VPWR),
    .VPWR(VPWR));
 sky130_fd_sc_hd__decap_8 FILLER_1_39 (.VGND(VGND),
    .VNB(VGND),
    .VPB(VPWR),
    .VPWR(VPWR));
 sky130_fd_sc_hd__fill_2 FILLER_1_47 (.VGND(VGND),
    .VNB(VGND),
    .VPB(VPWR),
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
    .VPWR(VPWR));
 sky130_fd_sc_hd__tapvpwrvgnd_1 TAP_24 (.VGND(VGND),
    .VPWR(VPWR));
 sky130_fd_sc_hd__tapvpwrvgnd_1 TAP_25 (.VGND(VGND),
    .VPWR(VPWR));
 sky130_fd_sc_hd__conb_1 _0__1 (.VGND(VGND),
    .VNB(VGND),
    .VPB(VPWR),
    .VPWR(VPWR),
    .LO(net1));
 sky130_fd_sc_hd__conb_1 _1__2 (.VGND(VGND),
    .VNB(VGND),
    .VPB(VPWR),
    .VPWR(VPWR),
    .LO(net2));
 assign out = net1;
 assign s_out = net2;
endmodule
