iic-jku/SKY130_PLL1/(commit log)

2022-07-06 first upload
    [complete_tails3.sch, d_ff_sim3.sch, delay_cell.sch, inv_buffer.sch, slopebuf_sim3.sch]
2022-07-19 PICO presentation
2022-07-20 symbols+new simulation
    [complete_tails5.sch, current_sw1.sch]
2022-08-23 add pin list for mock-tapeout
    [SSCS Chipathon Pin List.xlsx]
2022-08-30 update SSCS Pin List
    [SSCS Chipathon Pin List.xlsx]
2022-09-25 cleanup+organizing
    created a new file structure and added all relevant files again
    [SSCS Chipathon Pin List.xlsx, complete_testbench_2.sch, current_sw1.sch, current_tails1.sch, current_tg1.sch, current_vc1.sch, d_ff_2.sch, d_ff_sim3.sch]
2022-10-23 update files
    [complete_testbench_3.sch, differential.sch, differential_sim1.sch, inv_buffer2.sch, ota_2.sch, ota_2_sim.sch, slopebuf.sch, slopebuf_sim3.sch]
2022-11-11 file update
    [complete_testbench_5.sch, complete_testbench_6.sch, complete_testbench_7.sch, current_tails_1.sch, d_ff_10.sch, d_ff_15.sch, d_ff_sim8.sch, d_ff_sim9.sch]
2022-11-11 added wrapper
    [18-wire_lengths.csv, metrics.csv, pin_order.cfg, pin_order2.cfg, wrapper.ff.sdf, wrapper.sdf, wrapper.ss.sdf, wrapper.tt.sdf]
2022-11-13 first final round
    [18-wire_lengths.csv, complete_testbench_2.sch, complete_testbench_3.sch, complete_testbench_7.sch, current_tails1.sch, current_tg1.sch, current_vc1.sch, d_ff_2.sch]
2022-11-14 lvs+gds update
    [complete_wrapper.sch, out_buf.sch]
2022-11-28 lvs+gds update 2
    [complete_testbench.sch, full_IC_1.sch, full_IC_1_noplane.sch]
2024-04-05 PCB v1 added
    [SKY130_PLL_eval.kicad_pcb, SKY130_PLL_eval.kicad_sch, arty_shield.kicad_sch, ic_packaged.kicad_sch, pll_io.kicad_sch, power.kicad_sch]
2024-04-08 eval pcb added
    [SKY130_PLL_eval.kicad_pcb, SKY130_PLL_eval.kicad_sch, arty_shield.kicad_sch, ic_packaged.kicad_sch, pll_io.kicad_sch, power.kicad_sch]
2024-04-08 pin header labeling inserted
    [SKY130_PLL_eval.kicad_pcb]
2024-04-09 labels updated
    [SKY130_PLL_eval.kicad_pcb]
2024-04-09 minor layout changes
    [SKY130_PLL_eval.kicad_pcb]
2024-04-09 version updated to Kicad 8.0
    [SKY130_PLL_eval.kicad_sch, arty_shield.kicad_sch, ic_packaged.kicad_sch, pll_io.kicad_sch, power.kicad_sch]
2024-04-23 digital design evaluation added
    [actConfig.csv, pll_io.kicad_sch, regAllOff.csv]
2024-04-23 evaluation of digital part added
    [18-wire_lengths.csv, clock_divider.sdf, final_summary_report.csv, fll_wrapper_2.sdf, metrics.csv, pin_order.cfg, pin_order2.cfg, shiftregister.sdf]
