iic-jku/SKY130_PLL1/(notices)

Notices in the files:
eval/SKY130_PLL_eval_PCB/arty_shield.kicad_sch:
License: Apache 2.0
